LeaderXinjianSun/AutoSteelpasted/PLC/自动贴钢片机（珠海藤仓）资料.xlsx

Sheet: IO表
台达PLC
序号 | 输入端子 | 线标 |  | 工位 | 输出端子 | 线标 | 输出信号 | 工位
1 | X0.O | X0.O | 无杆气缸SET | PCB上料 | Y0.0 | Y0.0 |  | *预留 | AS332T
2 | X0.1 | X0.1 | 无杆气缸RST |  | Y0.1 | Y0.1
3 | X0.2 | X0.2 | 前推气缸SET |  | Y0.2 | Y0.2
4 | X0.3 | X0.3 | 前推气缸RST |  | Y0.3 | Y0.3
5 | X0.4 | X0.4 | 光纤 |  | Y0.4 | Y0.4
6 | X0.5 | X0.5 | 漫反射传感器 |  | Y0.5 | Y0.5
7 | X0.6 | X0.6 | 笼子接近开关1 |  | Y0.6 | Y0.6
8 | X0.7 | X0.7 | 笼子接近开关2 |  | Y0.7 | Y0.7
9 | X0.8 | X0.8 | 下压气缸1SET | 滚压工位 | Y0.8 | Y0.8
10 | X0.9 | X0.9 | 下压气缸2SET |  | Y0.9 | Y0.9
11 | X0.10 | X0.10 | 下压气缸1RST |  | Y0.10 | Y0.10
12 | X0.11 | X0.11 | 下压气缸2RST |  | Y0.11 | Y0.11
13 | X0.12 | X0.12 | 漫反射传感器 | 检测正反 | Y0.12 | Y0.12 | 无杆气缸 | PCB上料
14 | X0.13 | X0.13 | 上顶气缸RST |  | Y0.13 | Y0.13 | 前推气缸
15 | X0.14 | X0.14 | 负压表 |  | Y0.14 | Y0.14 | 下压气缸 | 滚压工位
16 | X0.15 | X0.15 | 漫反射传感器 | 贴膜 | Y0.15 | Y0.15 | 安全门信号输出
17 | X1.0 | X1.0 | 上顶气缸RST |  |  |  |  |  | AS16AM10N-A
18 | X1.1 | X1.1 | 负压表
19 | X1.2 | X1.2 | 漫反射传感器 | 压合
20 | X1.3 | X1.3 | 上顶气缸RST
21 | X1.4 | X1.4 | 负压表
22 | X1.5 | X1.5 | 漫反射传感器 | 撕膜
23 | X1.6 | X1.6 | 上顶气缸RST
24 | X1.7 | X1.7 | 负压表
25 | X1.8 | X1.8 | 漫反射传感器 | 贴钢片
26 | X1.9 | X1.9 | 上顶气缸RST
27 | X1.10 | X1.10 | 负压表
28 | X1.11 | X1.11 | 漫反射传感器 | 再压合
29 | X1.12 | X1.12 | 上顶气缸RST
30 | X1.13 | X1.13 | 负压表
31 | X1.14 | X1.14 | 漫反射传感器 | 检测钢片
32 | X1.15 | X1.15 | 上顶气缸RST
33 | X2.0 | X2.0 | 负压表 |  |  |  |  |  | AS16AM10N-A
34 | X2.1 | X2.1 | 漫反射传感器 | 打记号模组
35 | X2.2 | X2.2 | 上顶气缸RST
36 | X2.3 | X2.3 | 负压表
37 | X2.4 | X2.4 | 下压气缸SET
38 | X2.5 | X2.5 | 下压气缸RST
39 | X2.6 | X2.6 | 无杆气缸SET | 推出气缸
40 | X2.7 | X2.7 | 无杆气缸RST
41 | X2.8 | X2.8 | 无杆气缸SET | PCB下料
42 | X2.9 | X2.9 | 无杆气缸RST
43 | X2.10 | X2.10 | 光纤
44 | X2.11 | X2.11 | 漫反射传感器
45 | X2.12 | X2.12 | 笼子接近开关1
46 | X2.13 | X2.13 | 笼子接近开关2
47 | X2.14 | X2.14 | 无杆气缸SET | 膜上料
48 | X2.15 | X2.15 | 无杆气缸RST
49 | X3.0 | X3.0 | 推入到位接近开关1 |  |  |  |  |  | AS16AM10N-A
50 | X3.1 | X3.1 | 推入到位接近开关2
51 | X3.2 | X3.2 | 光纤1
52 | X3.3 | X3.3 | 光纤2
53 | X3.4 | X3.4 | 漫反射传感器1
54 | X3.5 | X3.5
55 | X3.6 | X3.6 | 无杆气缸SET | 钢片上料
56 | X3.7 | X3.7 | 无杆气缸RST
57 | X3.8 | X3.8 | 气缸RST
58 | X3.9 | X3.9 | 光纤1
59 | X3.10 | X3.10 | 光纤2
60 | X3.11 | X3.11 | 漫反射传感器1
61 | X3.12 | X3.12 | 漫反射传感器2
62 | X3.13 | X3.13 | 负压表
63 | X3.14 | X3.14 | 前门1 | 机壳
64 | X3.15 | X3.15 | 前门2
65 | X4.0 | X4.0 | 左门1 |  |  |  |  |  | AS16AM10N-A
66 | X4.1 | X4.1 | 左门2
67 | X4.2 | X4.2 | 后门1
68 | X4.3 | X4.3 | 后门2
69 | X4.4 | X4.4 | 右门1
70 | X4.5 | X4.5 | 右门2
71 | X4.6 | X4.6 | 急停按钮
72 | X4.7 | X4.7 | 启动按钮
73 | X4.8 | X4.8 | 停止按钮
74 | X4.9 | X4.9 | 复位按钮
75 | X4.10 | X4.10 | 正压表
76 | X4.11 | X4.11 | 到位传感器1 | 钢片上料
77 | X4.12 | X4.12 | 到位传感器2
78 | X4.13 | X4.13
79 | X4.14 | X4.14
80 | X4.15 | X4.15
81 |  |  |  |  | Y1.0 | Y1.0 | 挡块气缸 | 检测正反 | AS16AN01T-A
82 |  |  |  |  | Y1.1 | Y1.1 | 上顶气缸
83 |  |  |  |  | Y1.2 | Y1.2 | 真空吸
84 |  |  |  |  | Y1.3 | Y1.3 | 挡块气缸 | 贴膜
85 |  |  |  |  | Y1.4 | Y1.4 | 上顶气缸
86 |  |  |  |  | Y1.5 | Y1.5 | 真空吸
87 |  |  |  |  | Y1.6 | Y1.6 | 挡块气缸 | 压合
88 |  |  |  |  | Y1.7 | Y1.7 | 上顶气缸
89 |  |  |  |  | Y1.8 | Y1.8 | 真空吸
90 |  |  |  |  | Y1.9 | Y1.9 | 挡块气缸 | 撕膜
91 |  |  |  |  | Y1.10 | Y1.10 | 上顶气缸
92 |  |  |  |  | Y1.11 | Y1.11 | 真空吸
93 |  |  |  |  | Y1.12 | Y1.12 | 挡块气缸 | 再压合
94 |  |  |  |  | Y1.13 | Y1.13 | 上顶气缸
95 |  |  |  |  | Y1.14 | Y1.14 | 真空吸
96 |  |  |  |  | Y1.15 | Y1.15 | 挡块气缸 | 检测钢片
97 |  |  |  |  | Y2.0 | Y2.0 | 上顶气缸 |  | AS16AN01T-A
98 |  |  |  |  | Y2.1 | Y2.1 | 真空吸
99 |  |  |  |  | Y2.2 | Y2.2 | 挡块气缸 | 打记号模组
100 |  |  |  |  | Y2.3 | Y2.3 | 上顶气缸
101 |  |  |  |  | Y2.4 | Y2.4 | 真空吸
102 |  |  |  |  | Y2.5 | Y2.5 | 下压气缸
103 |  |  |  |  | Y2.6 | Y2.6 | 无杆气缸 | 推出气缸
104 |  |  |  |  | Y2.7 | Y2.7 | 上顶气缸
105 |  |  |  |  | Y2.8 | Y2.8 | 无杆气缸 | PCB下料
106 |  |  |  |  | Y2.9 | Y2.9 | 废膜气缸 | 废膜
107 |  |  |  |  | Y2.10 | Y2.10 | 无杆气缸 | 膜上料
108 |  |  |  |  | Y2.11 | Y2.11 | 无杆气缸 | 钢片上料
109 |  |  |  |  | Y2.12 | Y2.12 | 上下气缸
110 |  |  |  |  | Y2.13 | Y2.13 | 真空吸
111 |  |  |  |  | Y2.14 | Y2.14 | 控制灯继电器 | 机壳
112 |  |  |  |  | Y2.15 | Y2.15 | 三色灯-红
97 |  |  |  |  | Y3.0 | Y3.0 | 三色灯-黄 |  | AS16AN01T-A
98 |  |  |  |  | Y3.1 | Y3.1 | 三色灯-绿
99 |  |  |  |  | Y3.2 | Y3.2 | 三色灯-蜂鸣
100 |  |  |  |  | Y3.3 | Y3.3 | 传送带1驱动
101 |  |  |  |  | Y3.4 | Y3.4 | 传送带2驱动
102 |  |  |  |  | Y3.5 | Y3.5 | 滚轮驱动
103 |  |  |  |  | Y3.6 | Y3.6 | 夹爪气缸左 | 钢片上料
104 |  |  |  |  | Y3.7 | Y3.7 | 夹爪气缸右
105 |  |  |  |  | Y3.8 | Y3.8 | 挡块气缸
106 |  |  |  |  | Y3.9 | Y3.9 | 挡块气缸 | 贴钢片
107 |  |  |  |  | Y3.10 | Y3.10 | 上顶气缸
108 |  |  |  |  | Y3.11 | Y3.11 | 真空吸
109 |  |  |  |  | Y3.12 | Y3.12 | 上顶辅助气缸 | 撕膜
110 |  |  |  |  | Y3.13 | Y3.13
111 |  |  |  |  | Y3.14 | Y3.14
112 |  |  |  |  | Y3.15 | Y3.15
机械手1-RC90
序号 | 输入端子 | 线标 |  |  | 输出端子 | 线标 | 输出信号
1 | Input No.0 | IN0 | 负压表 |  | Output No.0 | OUT0 | 真空吸 |  | RC90
2 | Input No.1 | IN1 |  |  | Output No.1 | OUT1 | 吹气
3 | Input No.2 | IN2 |  |  | Output No.2 | OUT2 | 夹爪气缸
4 | Input No.3 | IN3 |  |  | Output No.3 | OUT3 | 下膜夹爪
5 | Input No.4 | IN4 |  |  | Output No.4 | OUT4 | 顶针气缸
6 | Input No.5 | IN5 |  |  | Output No.5 | OUT5
7 | Input No.6 | IN6 |  |  | Output No.6 | OUT6
8 | Input No.7 | IN7 |  |  | Output No.7 | OUT7
9 | Input No.8 | IN8 |  |  | Output No.8 | OUT8
10 | Input No.9 | IN9 |  |  | Output No.9 | OUT9
11 | Input No.10 | IN10 |  |  | Output No.10 | OUT10
12 | Input No.11 | IN11 |  |  | Output No.11 | OUT11
13 | Input No.12 | IN12 |  |  | Output No.12 | OUT12
14 | Input No.13 | IN13 |  |  | Output No.13 | OUT13
15 | Input No.14 | IN14 |  |  | Output No.14 | OUT14
16 | Input No.15 | IN15 |  |  | Output No.15 | OUT15 | 光源控制
17 | Input No.16 | IN16
18 | Input No.17 | IN17
19 | Input No.18 | IN18
20 | Input No.19 | IN19
21 | Input No.20 | IN20
22 | Input No.21 | IN21
23 | Input No.22 | IN22
24 | Input No.23 | IN23
机械手1-RC90
序号 | 输入端子 | 线标 |  |  | 输出端子 | 线标 | 输出信号
1 | Input No.0 | IN0 | 爪手1负压表 |  | Output No.0 | OUT0 | 爪手1真空吸 |  | RC90
2 | Input No.1 | IN1 | 爪手2负压表 |  | Output No.1 | OUT1 | 爪手1吹气
3 | Input No.2 | IN2 | 爪手3负压表 |  | Output No.2 | OUT2 | 爪手1上下气缸
4 | Input No.3 | IN3 | 爪手4负压表 |  | Output No.3 | OUT3 | 爪手2真空吸
5 | Input No.4 | IN4 | 爪手5负压表 |  | Output No.4 | OUT4 | 爪手2吹气
6 | Input No.5 | IN5 |  |  | Output No.5 | OUT5 | 爪手2上下气缸
7 | Input No.6 | IN6 |  |  | Output No.6 | OUT6 | 爪手3真空吸
8 | Input No.7 | IN7 |  |  | Output No.7 | OUT7 | 爪手3吹气
9 | Input No.8 | IN8 |  |  | Output No.8 | OUT8 | 爪手3上下气缸
10 | Input No.9 | IN9 |  |  | Output No.9 | OUT9 | 爪手4真空吸
11 | Input No.10 | IN10 |  |  | Output No.10 | OUT10 | 爪手4吹气
12 | Input No.11 | IN11 |  |  | Output No.11 | OUT11 | 爪手4上下气缸
13 | Input No.12 | IN12 |  |  | Output No.12 | OUT12 | 爪手5真空吸
14 | Input No.13 | IN13 |  |  | Output No.13 | OUT13 | 爪手5吹气
15 | Input No.14 | IN14 |  |  | Output No.14 | OUT14 | 爪手5上下气缸
16 | Input No.15 | IN15 |  |  | Output No.15 | OUT15 | 光源控制
17 | Input No.16 | IN16
18 | Input No.17 | IN17
19 | Input No.18 | IN18
20 | Input No.19 | IN19
21 | Input No.20 | IN20
22 | Input No.21 | IN21
23 | Input No.22 | IN22
24 | Input No.23 | IN23

Sheet: 物料清单 采购格式
 |  |  |  |  |  |  |  |  |  | 文件编号： | LDR-SJ-0220
物料清单（电气）: |  |  |  |  |  |  |  |  |  | 编号：
项目名称： |  | 自动贴钢片机 |  |  | 设计工程师： | 孙鑫建 |  |  | 制 单 时 间： |  | 20170818
客 户： |  | 珠海藤仓 |  |  | 领 料 人： |  |  |  | 装 配 时 间：
数 量： |  |  |  |  | 主 管 签 字： |  |  |  | 经 理 签 字：
序号 | 物料编号 | 物料名称 |  | 型号 |  | 品牌 | 数量 | 单位 | 单价 | 采购件 | 链接
1 |  | 控制 | 电脑主机 |  |  | 研华 | 1 | 台
2 |  |  | PLC 主机 | AS332T |  | 台达 | 1 | 个
3 |  |  | PLC 功能卡（CANopen通讯模块） | AS-FCOPM |  | 台达 | 1 | 个
4 |  |  | PLC IO扩展 | AS16AM10N-A |  | 台达 | 4 | 个
5 |  |  | PLC IO扩展 | AS16AN01T-A |  | 台达 | 3 | 个
6 |  |  | 端子台（AS300端子台，1M牛角插头延长线） | 端子台D024-K 延长线C4002- 1000 |  | 台达 | 1 | 套
7 |  |  | 交换机 | SF90D-16 |  | 思科 | 2 | 个
8 |  |  | 触摸屏 | DOP07SS411 |  | 台达 | 1 | 个
9 |  |  | 网线 | 2m |  |  | 6 | 根
10 |  |  | 网线 | 0.5m |  |  | 6 | 根
11 |  |  | 鼠标 | OP-520 |  | 双飞燕 | 1 | 个
12 |  |  | 键盘 | KL-5 |  | 双飞燕 | 1 | 个
13 |  |  | 笔形相机 | B005+ |  | 超眼 | 1 | 个 |  |  | https://detail.tmall.com/item.htm?id=21048944022&rn=f208cd8221aefa8242105d03a00c6e37&abbucket=3
14 |  |  | 显示器 | E1715S |  | 戴尔 | 1 | 个
15 |  | 视觉 | 工业相机 | MER-1070-10GM-P |  | 大恒 | 3 | 个
16 |  |  | 镜头 | OPT-C0825-5M |  |  | 3 | 个
17 |  |  | 条形光源 | LTS-2BR17530-W |  |  | 2 | 个
18 |  |  | 条形光源 | LTS-2BR7530-W |  |  | 2 | 个
19 |  |  | 背光源 | LTS-2FTR141141-W |  |  | 2 | 个
20 |  |  | 光源控制器 | LTS-DPC2475-4 |  |  | 1 | 个
21 |  |  | 光源控制器 | LTS-DPC2424-2 |  |  | 1 | 个
22 |  | 电机 | 伺服电机（100W，不带刹车） | ECMA-C20401ES |  | 台达 | 2 | 个
23 |  |  | 伺服驱动器（100W，CANopen通讯） | ASD-A2-0121-M |  | 台达 | 3 | 个
24 |  |  | 伺服电机（100W，带刹车） | ECMA-C20401FS |  | 台达 | 1 | 个
25 |  |  | 伺服驱动器(400W，CANopen通讯) | ASD-A2-0421-M |  | 台达 | 4 | 个
26 |  |  | 伺服电机(400W，带刹车) | ECMA-C20604SS |  | 台达 | 4 | 个
27 |  |  | 伺服线 |  |  | 台达 | 7 | 套
28 |  |  | 伺服CN1 |  |  | 台达 | 6 | 个
29 |  |  | 机械手 | LS3-401S |  | EPSON | 2 | 台
30 |  |  | 机器人控制器 | RC90 |  | EPSON | 2 | 台
31 |  |  | 脉冲发生器 | DKC-1A |  |  | 3 | 个
32 |  |  | 步进电机 | 57CM26 |  | 雷赛 | 1 | 个
33 |  |  | 步进电机 | 57HS13B-M |  | 雷赛 | 4 | 个
34 |  |  | 步进电机驱动器 | DM542 |  | 雷赛 | 5 | 个
35 |  | 电源 | 空气开关 | DZ47s-2P D10 |  | 德力西 | 5 | 个
36 |  |  | 漏电保护开关 | DZ47sLE C32 |  | 德力西 | 1 | 个
37 |  |  | 手柄+负荷开关 | VCF1C+V1C（32A） |  | 施耐德 | 1 | 个
38 |  |  | 单相滤波器 | SJD430D-30A |  | 上海赛纪 | 1 | 个
39 |  | 机柜 | 三色灯 | XVG-B3SM |  | 施耐德 | 1 | 个
40 |  |  | 风扇 | DLF1224LB |  |  | 6 | 个
41 |  |  | 按钮 | XB5AA31C NO |  | 施耐德 | 3 | 个
42 |  |  | 急停按钮 | XB5AS542C 1NC |  | 施耐德 | 4 | 个
43 |  |  | 急停按钮黄色标牌 |  |  |  | 4 | 个
44 |  |  | 急停按钮保护罩 |  |  |  | 4 | 个
45 |  |  | 电源指示灯 | XB7EVM3LC |  | 施耐德 | 1 | 个
46 |  |  | 防暴LED灯 |  |  |  | 1 | 个
47 |  |  | 门开关 | FM18-08N |  |  | 8 | 个
48 |  |  | 继电器 | MY2N-GS |  |  | 10 | 个
49 |  |  | 开关电源 | NDR-120-24 120W |  | 铭纬 | 1 | 个
50 |  |  | 开关电源 | NDR-480-24 480W |  | 铭纬 | 1 | 个
51 |  |  | 传感器(方缸) | DS1-J |  | SMC | 4 | 个
52 |  |  | 传感器（无杆气缸） | GL-8H |  | SMC | 16 | 个
53 |  |  | 传感器（下料上下） | DMSH-020 |  | SMC | 3 | 个
54 |  |  | 光纤传感器 | FU-35 |  | 基恩士 | 4 | 个
55 |  |  | 光纤放大器 | FS-V21R |  | 基恩士 | 4 | 个
56 |  |  | 光纤传感器 | PT3Y20 |  | BOJKE | 2 | 个
57 |  |  | 光纤放大器 | ER2-22 |  | BOJKE | 2 | 个
58 |  |  | 激光光电传感器 | BG-40N |  | BOJKE | 2 | 个
59 |  |  | 光电传感器 | E3ZG-D61 |  | 欧姆龙 | 13 | 个
60 |  |  | 光电开关 | LU672-5NA |  | HUAYIFENG | 16 | 个 |  |  | http://www.hyfcn.com/caoxingguangdianchuanganqi/40-30.html
61 |  |  | 转接板 | ST081N |  |  | 18 | 个
62 |  |  | 开关面板 | 118型十孔 |  | 公牛 | 1 | 个
63 |  |  | 开关面板暗盒 | 118型十孔暗盒 |  | 公牛 | 1 | 个
64 |  |  | DB50端子台 | 孔座 |  |  | 2 | 个
65 |  |  | DB25端子台 | 孔座 |  |  | 2 | 个
66 |  |  | DB50连接线 | 公对母3米 |  |  | 2 | 个
67 |  |  | DB25连接线 | 公对母3米 |  |  | 2 | 个
68 |  | 气动 | 电磁阀 | SY3120-12连 |  | SMC | 2 | 个
69 |  |  | 电磁阀 | SY3120-7连 |  | SMC | 1 | 个
70 |  |  | 电磁阀 | SY3120单体 |  | SMC | 7 | 个
71 |  |  | 电磁阀 | 3V21008NCBI |  | 亚德客 | 10 | 个
72 |  |  | 多功能真空发生器 | ZK2A07K5KW-06 |  | SMC | 6 | 个
73 |  |  | 负压表 | DP-101 |  | 松下 | 9 | 个
74 |  |  | 电源线 | 2m |  |  | 2 | 根
75 |  |  | VGA线 | 3m |  |  | 1 | 根
76 |  |  | 接地柱 |  |  |  | 1 | 个
77 |  |  | 接地排 |  |  |  | 1 | 个
78 |  |  | 2.5mm 导线（黑色） |  |  |  |  | 米
79 |  |  | 2.5mm 导线 （蓝色） |  |  |  |  | 米
80 |  |  | 2.5mm 导线 （黄绿） |  |  |  |  | 米
81 |  |  | 1 mm 导线 （红色） |  |  |  |  | 米
82 |  |  | 1 mm 导线 （白色） |  |  |  |  | 米
83 |  |  | 0.5mm 导线 （黑色） |  |  |  |  | 米
84 |  |  | 多芯线 10芯 |  |  |  |  | 米
85 |  |  | 捷固端子 |  |  |  |  | 个
86 |  |  | 接地端子 |  |  |  |  | 个
87 |  |  | U型线鼻子 |  |  |  |  | 个
88 |  |  | 空中接头 |  |  |  |  | 个
89 |  |  | O型线鼻子 |  |  |  |  | 个
90 |  |  | 马鞍型固定座 |  |  |  |  | 个
91 |  |  | 导轨 |  |  |  |  | 米
92 |  |  | 线槽 |  |  |  |  | 米
93 |  |  | 插头 |  |  |  | 1 | 个

Sheet: 装配规划
工位 | PCB上料 |  |  | 工位 | 滚压 |  |  | 工位 | 检测正反 |  |  | 工位 | 贴膜 |  |  | 工位 | 压合 |  |  | 工位 | 撕膜
输入 | 数量 | 输出 | 数量 | 输入 | 数量 | 输出 | 数量 | 输入 | 数量 | 输出 | 数量 | 输入 | 数量 | 输出 | 数量 | 输入 | 数量 | 输出 | 数量 | 输入 | 数量 | 输出 | 数量
无杆气缸接近开关 | 2 | 无杆气缸 | 1 | 下压气缸传感器 | 4 | 下压气缸 | 1 | 漫反射传感器 | 1 | 挡块气缸 | 1 | 漫反射传感器 | 1 | 挡块气缸 | 1 | 漫反射传感器 | 1 | 挡块气缸 | 1 | 漫反射传感器 | 1 | 挡块气缸 | 1
前推气缸传感器 | 2 | 前推气缸 | 1 |  |  |  |  | 上顶气缸传感器 | 1 | 上顶气缸 | 1 | 上顶气缸传感器 | 1 | 上顶气缸 | 1 | 上顶气缸传感器 | 1 | 上顶气缸 | 1 | 上顶气缸传感器 | 1 | 上顶气缸 | 1
电机极限 | 2 |  |  |  |  |  |  | 负压表 | 1 | 真空吸 | 1 | 负压表 | 1 | 真空吸 | 1 | 负压表 | 1 | 真空吸 | 1 | 负压表 | 1 | 真空吸 | 1
光纤 | 1 |  |  |  |  |  |  |  |  |  |  |  |  |  |  |  |  | 单作用气缸 | 1
漫反射传感器 | 1
笼子接近开关 | 2
 |  |  |  | 工位 | 贴钢片 |  |  | 工位 | 压合 |  |  | 工位 | 检测钢片 |  |  | 工位 | 打记号模组 |  |  | 工位 | 推出气缸 |  |  | 工位 | PCB下料
 |  |  |  | 输入 | 数量 | 输出 | 数量 | 输入 | 数量 | 输出 | 数量 | 输入 | 数量 | 输出 | 数量 | 输入 | 数量 | 输出 | 数量 | 输入 | 数量 | 输出 | 数量 | 输入 | 数量 | 输出 | 数量
 |  |  |  | 漫反射传感器 | 1 | 挡块气缸 | 1 | 漫反射传感器 | 1 | 挡块气缸 | 1 | 漫反射传感器 | 1 | 挡块气缸 | 1 | 漫反射传感器 | 1 | 挡块气缸 | 1 | 无感气缸传感器 | 2 | 无杆气缸 | 1 | 无杆气缸接近开关 | 2 | 无杆气缸 | 1
 |  |  |  | 上顶气缸传感器 | 1 | 上顶气缸 | 1 | 上顶气缸传感器 | 1 | 上顶气缸 | 1 | 上顶气缸传感器 | 1 | 上顶气缸 | 1 | 上顶气缸传感器 | 1 | 上顶气缸 | 1 |  |  | 上顶气缸 | 1 | 电机极限 | 2
 |  |  |  | 负压表 | 1 | 真空吸 | 1 | 负压表 | 1 | 真空吸 | 1 | 负压表 | 1 | 真空吸 | 1 | 负压表 | 1 | 真空吸 | 1 |  |  |  |  | 光纤 | 1
 |  |  |  |  |  |  |  |  |  | 单作用气缸 | 1 |  |  |  |  | 电机极限 | 4 | 下压气缸 | 1 |  |  |  |  | 漫反射传感器 | 1
 |  |  |  |  |  |  |  |  |  |  |  |  |  |  |  | 气缸传感器 | 2 |  |  |  |  |  |  | 笼子接近开关 | 2
 |  |  |  | 工位 | 机械手1 |  |  | 工位 | 废膜 |  |  | 工位 | 机械手2
 |  |  |  | 输入 | 数量 | 输出 | 数量 | 输入 | 数量 | 输出 | 数量 | 输入 | 数量 | 输出 | 数量
 |  |  |  | 负压表 | 1 | 气缸 | 1 |  |  | 气缸 | 1 | 负压表 | 5 | 气缸 | 5
 |  |  |  |  |  | 真空吸 | 1 |  |  |  |  |  |  | 真空吸 | 5
 |  |  |  |  |  | 吹气 | 1 |  |  |  |  |  |  | 吹气 | 5
工位 | 机壳 |  |  | 工位 | 膜上料 |  |  | 工位 | 钢片上料
输入 | 数量 | 输出 | 数量 | 输入 | 数量 | 输出 | 数量 | 输入 | 数量 | 输出 | 数量
门感应 | 8 | 三色灯 | 1 | 电机极限 | 2 | 无杆气缸 | 1 | 电机极限 | 4 | 无杆气缸 | 1
急停 | 1 |  |  | 无杆气缸传感器 | 2 |  |  | 无杆气缸传感器 | 2 | 上下气缸 | 1
按钮 | 3 |  |  | 推入到位传感器 | 2 |  |  | 气缸传感器 | 1 | 真空吸 | 1
 |  |  |  | 膜到位光纤 | 2 |  |  | 膜到位光纤 | 2
 |  |  |  | 漫反射传感器 | 1 |  |  | 漫反射传感器 | 2
 |  |  |  |  |  |  |  | 负压表 | 1

Sheet: 多芯线
多芯线编号 | 序号 | 颜色 | 线标 |  | 区域
1 | 1 | 红 |  | 24V | PCB上料
 | 2 | 黑 | X0.O | 无杆气缸SET
 | 3 | 棕 | X0.1 | 无杆气缸RST
 | 4 | 橙 | X0.2 | 前推气缸SET
 | 5 | 黄 | X0.3 | 前推气缸RST
 | 6 | 绿 | X0.4 | 光纤
 | 7 | 兰 | X0.5 | 漫反射传感器
 | 8 | 紫 | X0.6 | 笼子接近开关1
 | 9 | 灰 | X0.7 | 笼子接近开关2
 | 10 | 白 |  | 0V
多芯线编号 | 序号 | 颜色 |  |  | 区域 | 传送带1
2 | 1 | 红 |  | 24V | PCB上料
 | 2 | 黑 | LIM1+ | 电机1极限+
 | 3 | 棕 | LIM1- | 电机1极限-
 | 4 | 橙
 | 5 | 黄
 | 6 | 绿
 | 7 | 兰
 | 8 | 紫
 | 9 | 灰
 | 10 | 白 |  | 0V
多芯线编号 | 序号 | 颜色 |  |  | 区域
3 | 1 | 红 |  | 24V
 | 2 | 黑 | X0.8 | 下压气缸1SET | 滚压工位
 | 3 | 棕 | X0.9 | 下压气缸2SET
 | 4 | 橙 | X0.10 | 下压气缸1RST
 | 5 | 黄 | X0.11 | 下压气缸2RST
 | 6 | 绿 | X0.12 | 漫反射传感器 | 检测正反
 | 7 | 兰 | X0.13 | 上顶气缸RST
 | 8 | 紫 | X0.14 | 负压表
 | 9 | 灰 | X0.15 | 漫反射传感器 | 贴膜
 | 10 | 白 |  | 0V
多芯线编号 | 序号 | 颜色 |  |  | 区域
4 | 1 | 红 |  | 24V
 | 2 | 黑 | X1.0 | 上顶气缸RST | 贴膜
 | 3 | 棕 | X1.1 | 负压表
 | 4 | 橙 | X1.2 | 漫反射传感器 | 压合
 | 5 | 黄 | X1.3 | 上顶气缸RST
 | 6 | 绿 | X1.4 | 负压表
 | 7 | 兰 | X1.5 | 漫反射传感器 | 撕膜
 | 8 | 紫 | X1.6 | 上顶气缸RST
 | 9 | 灰 | X1.7 | 负压表
 | 10 | 白 |  | 0V
多芯线编号 | 序号 | 颜色 |  |  | 区域 | 传送带2
5 | 1 | 红 |  | 24V
 | 2 | 黑 | X1.8 | 漫反射传感器 | 贴钢片
 | 3 | 棕 | X1.9 | 上顶气缸RST
 | 4 | 橙 | X1.10 | 负压表 | 再压合
 | 5 | 黄 | X1.11 | 漫反射传感器
 | 6 | 绿 | X1.12 | 上顶气缸RST
 | 7 | 兰 | X1.13 | 负压表 | 检测钢片
 | 8 | 紫 | X1.14 | 漫反射传感器
 | 9 | 灰 | X1.15 | 上顶气缸RST
 | 10 | 白 |  | 0V
多芯线编号 | 序号 | 颜色 |  |  | 区域
6 | 1 | 红 |  | 24V
 | 2 | 黑 | X2.0 | 负压表 | 打记号模组
 | 3 | 棕 | X2.1 | 漫反射传感器
 | 4 | 橙 | X2.2 | 上顶气缸RST
 | 5 | 黄 | X2.3 | 负压表
 | 6 | 绿 | LIM7+ | 电机7极限+
 | 7 | 兰 | LIM7- | 电机7极限-
 | 8 | 紫 | X2.6 | 无杆气缸SET | 推出气缸
 | 9 | 灰 | X2.7 | 无杆气缸RST
 | 10 | 白 |  | 0V
多芯线编号 | 序号 | 颜色 |  |  | 区域 | 移动模组
7 | 1 | 红 |  | 24V
 | 2 | 黑 | LIM6+ | 电机6极限+ | 打记号模组
 | 3 | 棕 | LIM6- | 电机6极限-
 | 4 | 橙 | X2.4 | 下压气缸SET
 | 5 | 黄 | X2.5 | 下压气缸RST
 | 6 | 绿
 | 7 | 兰
 | 8 | 紫
 | 9 | 灰
 | 10 | 白 |  | 0V
多芯线编号 | 序号 | 颜色 |  |  | 区域
8 | 1 | 红 |  | 24V
 | 2 | 黑 | X2.8 | 无杆气缸SET | PCB下料
 | 3 | 棕 | X2.9 | 无杆气缸RST
 | 4 | 橙 | X2.10 | 光纤
 | 5 | 黄 | X2.11 | 漫反射传感器
 | 6 | 绿 | X2.12 | 笼子接近开关1
 | 7 | 兰 | X2.13 | 笼子接近开关2
 | 8 | 紫 | LIM5+ | 电机5极限+
 | 9 | 灰 | LIM5- | 电机5极限-
 | 10 | 白 |  | 0V
多芯线编号 | 序号 | 颜色 |  |  | 区域
9 | 1 | 红 |  | 24V
 | 2 | 黑 | X2.14 | 无杆气缸SET | 膜上料
 | 3 | 棕 | X2.15 | 无杆气缸RST
 | 4 | 橙 | X3.0 | 推入到位接近开关1
 | 5 | 黄 | X3.1 | 推入到位接近开关2
 | 6 | 绿 | X3.2 | 光纤1
 | 7 | 兰 | X3.3 | 光纤2
 | 8 | 紫 | X3.4 | 漫反射传感器1
 | 9 | 灰
 | 10 | 白 |  | 0V
多芯线编号 | 序号 | 颜色 |  |  | 区域
10 | 1 | 红 |  | 24V
 | 2 | 黑 | LIM2+ | 电机2极限+ | 膜上料
 | 3 | 棕 | LIM2- | 电机2极限-
 | 4 | 橙
 | 5 | 黄
 | 6 | 绿
 | 7 | 兰
 | 8 | 紫
 | 9 | 灰
 | 10 | 白 |  | 0V
多芯线编号 | 序号 | 颜色 |  |  | 区域
11 | 1 | 红 |  | 24V
 | 2 | 黑 | X3.6 | 无杆气缸SET | 钢片上料
 | 3 | 棕 | X3.7 | 无杆气缸RST
 | 4 | 橙 | X3.8 | 气缸RST
 | 5 | 黄 | X3.9 | 光纤1
 | 6 | 绿 | X3.10 | 光纤2
 | 7 | 兰 | X3.11 | 漫反射传感器1
 | 8 | 紫 | X3.12 | 漫反射传感器2
 | 9 | 灰 | X3.13 | 负压表
 | 10 | 白 |  | 0V
多芯线编号 | 序号 | 颜色 |  |  | 区域
12 | 1 | 红 |  | 24V
 | 2 | 黑 | LIM3+ | 电机3极限+ | 钢片上料
 | 3 | 棕 | LIM3- | 电机3极限-
 | 4 | 橙 | LIM4+ | 电机4极限+
 | 5 | 黄 | LIM4- | 电机4极限-
 | 6 | 绿
 | 7 | 兰
 | 8 | 紫
 | 9 | 灰
 | 10 | 白 |  | 0V
多芯线编号 | 序号 | 颜色 |  |  | 区域 | 机械手1
13 | 1 | 红 |  | 24V
 | 2 | 黑 | IN0 | 负压表 | 机械手1
 | 3 | 棕 | OUT0 | 真空吸
 | 4 | 橙 | OUT1 | 吹气
 | 5 | 黄 | OUT2 | 夹爪气缸
 | 6 | 绿
 | 7 | 兰
 | 8 | 紫
 | 9 | 灰
 | 10 | 白 |  | 0V
多芯线编号 | 序号 | 颜色 |  |  | 区域 | 机械手2
14 | 1 | 红 |  | 24V
 | 2 | 黑 | IN0 | 爪手1负压表 | 机械手2
 | 3 | 棕 | IN1 | 爪手2负压表
 | 4 | 橙 | IN2 | 爪手3负压表
 | 5 | 黄 | IN3 | 爪手4负压表
 | 6 | 绿 | IN4 | 爪手5负压表
 | 7 | 兰 | OUT0 | 爪手1真空吸
 | 8 | 紫 | OUT1 | 爪手1吹气
 | 9 | 灰 | OUT2 | 爪手1上下气缸
 | 10 | 白 |  | 0V
多芯线编号 | 序号 | 颜色 |  |  | 区域
15 | 1 | 红 |  | 24V
 | 2 | 黑 | OUT3 | 爪手2真空吸 | 机械手2
 | 3 | 棕 | OUT4 | 爪手2吹气
 | 4 | 橙 | OUT5 | 爪手2上下气缸
 | 5 | 黄 | OUT6 | 爪手3真空吸
 | 6 | 绿 | OUT7 | 爪手3吹气
 | 7 | 兰 | OUT8 | 爪手3上下气缸
 | 8 | 紫 | OUT9 | 爪手4真空吸
 | 9 | 灰 | OUT10 | 爪手4吹气
 | 10 | 白 |  | 0V
多芯线编号 | 序号 | 颜色 |  |  | 区域
16 | 1 | 红 |  | 24V
 | 2 | 黑 | OUT11 | 爪手4上下气缸 | 机械手2
 | 3 | 棕 | OUT12 | 爪手5真空吸
 | 4 | 橙 | OUT13 | 爪手5吹气
 | 5 | 黄 | OUT14 | 爪手5上下气缸
 | 6 | 绿
 | 7 | 兰
 | 8 | 紫
 | 9 | 灰
 | 10 | 白 |  | 0V
多芯线编号 | 序号 | 颜色 |  |  | 区域 | 机壳
17 | 1 | 红 |  | 24V
 | 2 | 黑 | X3.14 | 前门1 | 机壳
 | 3 | 棕 | X3.15 | 前门2
 | 4 | 橙 | X4.0 | 左门1
 | 5 | 黄 | X4.1 | 左门2
 | 6 | 绿 | X4.2 | 后门1
 | 7 | 兰 | X4.3 | 后门2
 | 8 | 紫 | X4.4 | 右门1
 | 9 | 灰 | X4.5 | 右门2
 | 10 | 白 |  | 0V
多芯线编号 | 序号 | 颜色 |  |  | 区域
18 | 1 | 红 |  | 24V
 | 2 | 黑 | X4.6 | 急停按钮 | 机壳
 | 3 | 棕 | X4.7 | 启动按钮
 | 4 | 橙 | X4.8 | 停止按钮
 | 5 | 黄 | X4.9 | 复位按钮
 | 6 | 绿 | Y2.15 | 三色灯-红
 | 7 | 兰 | Y3.0 | 三色灯-黄
 | 8 | 紫 | Y3.1 | 三色灯-绿
 | 9 | 灰 | Y3.2 | 三色灯-蜂鸣
 | 10 | 白 |  | 0V

Sheet: 伺服端子接线图
线序 | 颜色 | 端子号 | 线标 | 信号
1 | 粉 | 1 | DO4+ | 刹车+
2 | 红 | 11 | COM+ | 公共端+
3 | 褐 | 26 | DO4- | 刹车-
4 | 蓝 | 31 | DI7- | PL正转极限
5 | 绿 | 32 | DI6- | NL反转极限
6 | 黄 | 49 | COM- | 公共端-

Sheet: 编程规划
 |  |  | 导程
 |  |  | 5
 |  |  | 10
 |  | M5000
轴1 | PCB上料
轴2 | 膜上料
轴3 | 钢片上料左
轴4 | 钢片上料右
轴5 | PCB下料
轴6 | 打记号Y轴
轴7 | 打记号X轴
M100 | 与机械手1通信
M200 | 与机械手2通信
M300 | 与上位机通信

Sheet: 通信
 | PLC | PC |  |  |  |  |  | PLC | 机械手1 |  |  |  |  |  | PLC | 机械手2
 | 输入 |  |  | 输出 |  |  |  | 输入 |  |  | 输出 |  |  |  | 输入 |  |  | 输出
1 | M350 | YY0 | 检测正反完成 | M300 | XX0 | 检测正反工位RDY | 1 | M150 | PLCOUT0 | 膜取完成 | M100 | PLCIN0 | 膜左RDY | 1 | M250 | PLCOUT0 | 钢片取完成 | M200 | PLCIN0 | 钢片RDY
2 | M351 | YY1 | 检测钢片完成 | M301 | XX1 | 检测钢片工位RDY | 2 | M151 | PLCOUT1 | 夹爪气缸 | M101 | PLCIN1 | 膜右RDY | 2 | M251 | PLCOUT1 | 贴钢片完成 | M201 | PLCIN1 | 贴钢片工位RDY
3 | M352 | YY2 | 钢片1结果 | M302 | XX2 |  | 3 | M152 | PLCOUT2 | 贴膜完成 | M102 | PLCIN2 | 贴膜工位RDY | 3 | M252 | PLCOUT2 |  | M202 | PLCIN2 | 钢片上料安全
4 | M353 | YY3 | 钢片2结果 | M303 | XX3 |  | 4 | M153 | PLCOUT3 | 撕膜完成 | M103 | PLCIN3 | 撕膜工位RDY | 4 | M253 | PLCOUT3 |  | M203 | PLCIN3
5 | M354 | YY4 | 钢片3结果 | M304 | XX4 |  | 5 | M154 | PLCOUT4 |  | M104 | PLCIN4 |  | 5 | M254 | PLCOUT4 |  | M204 | PLCIN4
6 | M355 | YY5 | 钢片4结果 | M305 | XX5 |  | 6 | M155 | PLCOUT5 |  | M105 | PLCIN5 |  | 6 | M255 | PLCOUT5 |  | M205 | PLCIN5
7 | M356 | YY6 | 钢片5结果 | M306 | XX6 |  | 7 | M156 | PLCOUT6 |  | M106 | PLCIN6 |  | 7 | M256 | PLCOUT6 |  | M206 | PLCIN6
8 | M357 | YY7 | 钢片6结果 | M307 | XX7 |  | 8 | M157 | PLCOUT7 |  | M107 | PLCIN7 |  | 8 | M257 | PLCOUT7 |  | M207 | PLCIN7
9 | M358 | YY8 | 钢片7结果 | M308 | XX8 |  | 9 | M158 | PLCOUT8 |  | M108 | PLCIN8 |  | 9 | M258 | PLCOUT8 |  | M208 | PLCIN8
10 | M359 | YY9 | 钢片8结果 | M309 | XX9
11 | M360 | YY10 | 钢片9结果 | M310 | XX10 | 等待PCB板上料篮
12 | M361 | YY11 | 钢片10结果 | M311 | XX11 | 等待胶上料
13 | M362 | YY12 | 钢片11结果 | M312 | XX12 | 等待钢片上料
14 | M363 | YY13 | 钢片12结果 | M313 | XX13 | 等待钢片空盘取走
15 | M364 | YY14 | 钢片13结果 | M314 | XX14 | 等待PCB板下料篮
16 | M365 | YY15 | 钢片14结果 | M315 | XX15 | 等待钢片上料
17 | M366 | YY16 | 钢片15结果 | M316 | XX16 | 等待钢片空盘取走
18 | M367 | YY17 | 钢片16结果 | M317 | XX17 | 产量到达设定值
19 | M368 | YY18 | 钢片17结果 | M318 | XX18
20 | M369 | YY19 | 钢片18结果 | M319 | XX19
21 | M370 | YY20 | 钢片19结果 | M320 | XX20
22 | M371 | YY21 | 钢片20结果 | M321 | XX21
23 | M372 | YY22 | 钢片21结果 | M322 | XX22
24 | M373 | YY23 | 钢片22结果 | M323 | XX23
25 | M374 | YY24 | 钢片23结果 | M324 | XX24
26 | M375 | YY25 | 钢片24结果 | M325 | XX25
27 | M376 | YY26 | 钢片25结果 | M326 | XX26
28 | M377 | YY27 |  | M327 | XX27
29 | M378 | YY28 |  | M328 | XX28
30 | M379 | YY29 |  | M329 | XX29
31 | M380 | YY30 |  | M330 | XX30
32 | M381 | YY31 |  | M331 | XX31
33 | M382 | YY32 |  | M332 | XX32
34 | M383 | YY33 |  | M333 | XX33
35 | M384 | YY34 |  | M334 | XX34
36 | M385 | YY35 |  | M335 | XX35
37 | M386 | YY36 |  | M336 | XX36
38 | M387 | YY37 |  | M337 | XX37
39 | M388 | YY38 |  | M338 | XX38
40 | M389 | YY39 |  | M339 | XX39
41 | M390 | YY40 | 急停信号 | M340 | XX40
42 | M391 | YY41 | PCB上料确认 | M341 | XX41
43 | M392 | YY42 | 膜上料确认 | M342 | XX42
44 | M393 | YY43 | 钢片上料确认 | M343 | XX43
45 | M394 | YY44 | 钢片空盘取走确认 | M344 | XX44
46 | M395 | YY45 | PCB下料确认 | M345 | XX45
47 | M396 | YY46 | 钢片退料 | M346 | XX46
48 | M397 | YY47 |  | M347 | XX47
49 | M398 | YY48 | 机械手1暂停 | M348 | XX48
50 | M399 | YY49 | 机械手2暂停 | M349 | XX49

Sheet: Sheet2
206.608 | 208.007 | -185.778
117.034 | 118.433 | -289.394
89.574
89.574 | 208.007 | -25.904 | -25.904
 |  | 103.616 | 103.616
211.115 | 210.995
0.12 | 0.03
 |  |  | 271.543
 |  |  | 245.543 | 245.543
 |  |  | 219.543 | 219.543
 |  |  | 193.543 | 193.543
 |  |  | 167.543 | 167.543
 |  |  | 141.543
 |  |  | 115.543
 |  |  | 89.543
 |  |  | 63.543
 |  |  | 37.543

Sheet: 报警
M4000 | 钢片空盘吸取失败
M4001 | 暂停
M4002 | 急停
M4003 | 运行
M4004 | 前门1
M4005 | 前门2
M4006 | 左门1
M4007 | 左门2
M4008 | 后门1
M4009 | 后门2
M4010 | 右门1
M4011 | 右门2
M4012 | PCB上料轴伺服报警
M4013 | 膜上料轴伺服报警
M4014 | 钢片左轴伺服报警
M4015 | 钢片右轴伺服报警
M4016 | PCB下料轴伺服报警
M4017 | AOIX轴伺服报警
M4018 | AOIY轴伺服报警
M4019
M4020 | 机械手1暂停
M4021 | 机械手2暂停
M4022 | 等待PCB板上料篮
M4023 | 等待胶上料
M4024 | 等待钢片上料
M4025 | 等待钢片空盘取走
M4026 | 等待PCB板下料篮
M4027 | 等待钢片上料
M4028 | 等待钢片空盘取走
M4029 | 产量到达设定值
M4030
M4031 | 检测正反工位真空吸未达到
M4032 | 贴胶工位真空吸未达到
M4033 | 压合工位真空吸未达到
M4034 | 撕上膜工位真空吸未达到
M4035 | 贴钢片工位真空吸未达到
M4036 | 再压合工位真空吸未达到
M4037 | AOI工位真空吸未达到
M4038 | 做记号工位无杆气缸未到位
M4039
M4040
