LeaderXinjianSun/AutoSteelpasted/(list of files, cad)

Other CAD files:
GangpianRobot1/Main.obj
PLC/自动贴钢片机/01.dwg
GangpianRobot1/GangpianRobot1.obj
PLC/自动贴钢片机/06.dwg
PLC/自动贴钢片机/19.dwg
PLC/自动贴钢片机/05.dwg
PLC/自动贴钢片机/08.dwg
PLC/自动贴钢片机/11.dwg
PLC/自动贴钢片机/21.dwg
PLC/自动贴钢片机/16.dwg
PLC/自动贴钢片机/24.dwg
PLC/自动贴钢片机/22.dwg
PLC/自动贴钢片机/04.dwg
PLC/自动贴钢片机/10.dwg
PLC/自动贴钢片机/14.dwg
PLC/自动贴钢片机/07.dwg
PLC/自动贴钢片机/17.dwg
PLC/自动贴钢片机/12.dwg
PLC/自动贴钢片机/13.dwg
PLC/自动贴钢片机/26.dwg
PLC/自动贴钢片机/09.dwg
PLC/自动贴钢片机/23.dwg
PLC/自动贴钢片机/02.dwg
PLC/自动贴钢片机/25.dwg
PLC/自动贴钢片机/20.dwg
PLC/自动贴钢片机/15.dwg
PLC/自动贴钢片机/18.dwg
PLC/自动贴钢片机/03.dwg
