LeaderXinjianSun/AutoSteelpasted/PLC/珠海藤仓自动贴钢片机电路图.pdf

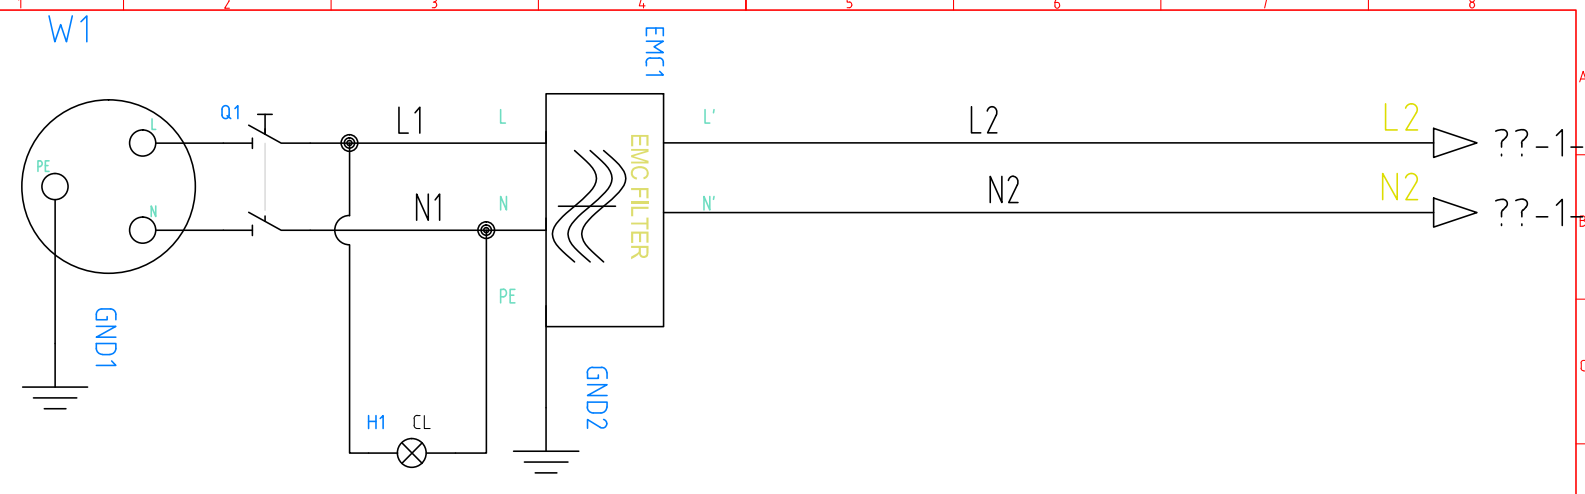
[picture p1: page 1]

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

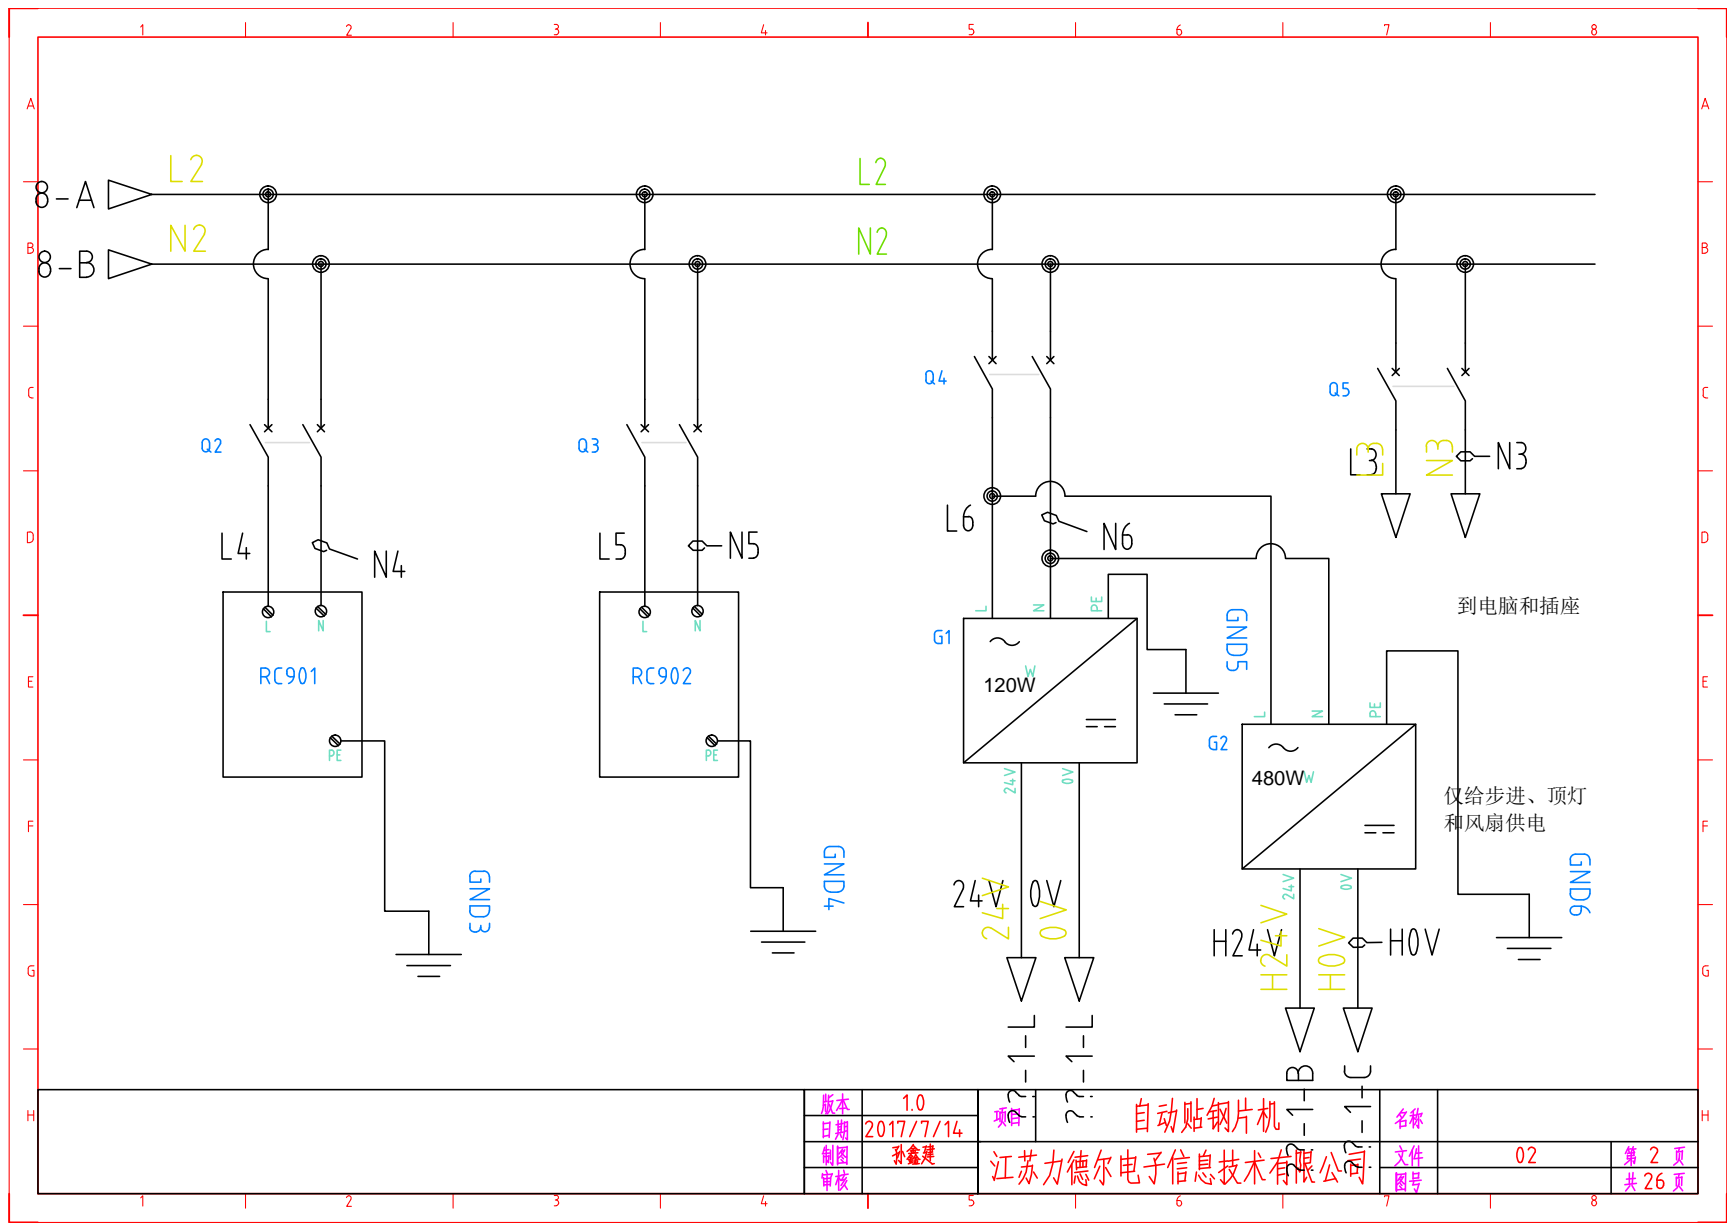
[picture p2: page 2]

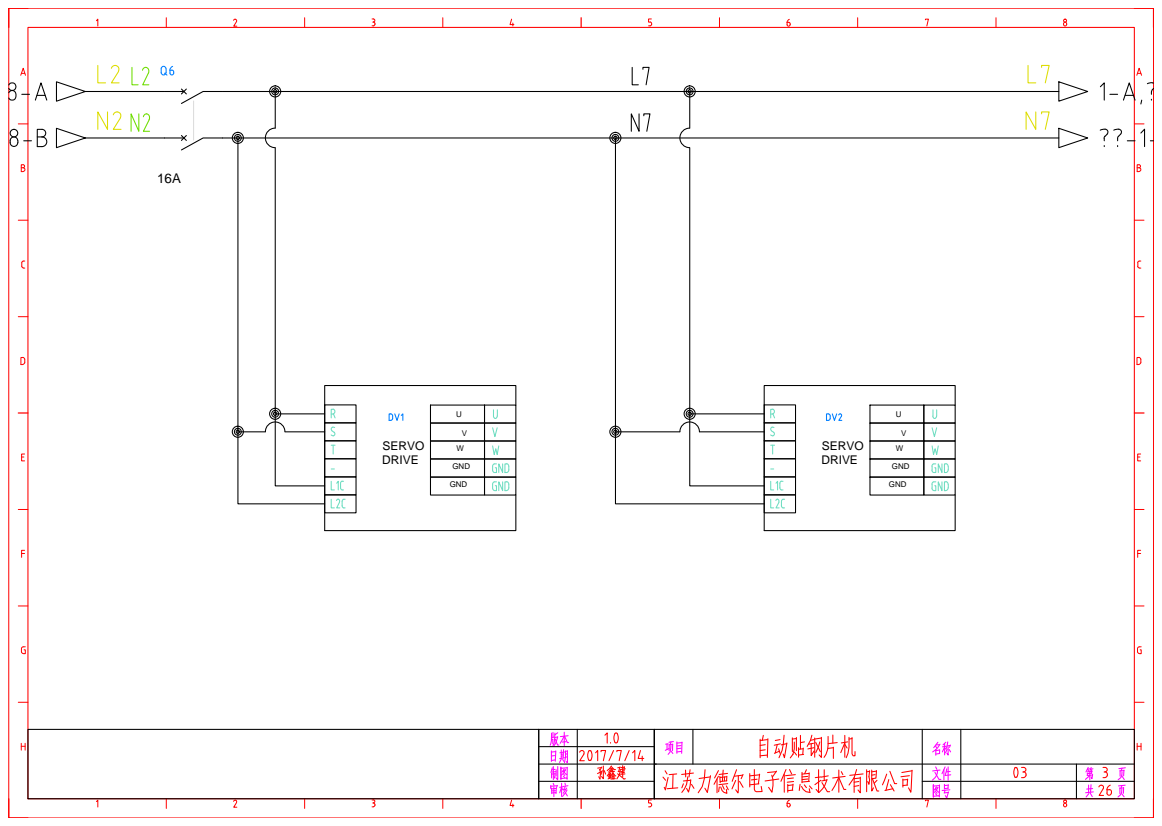
[picture p3: page 3]
GND W; VUGND SERVO DRIVE

VUGND SERVO DRIVE 16A

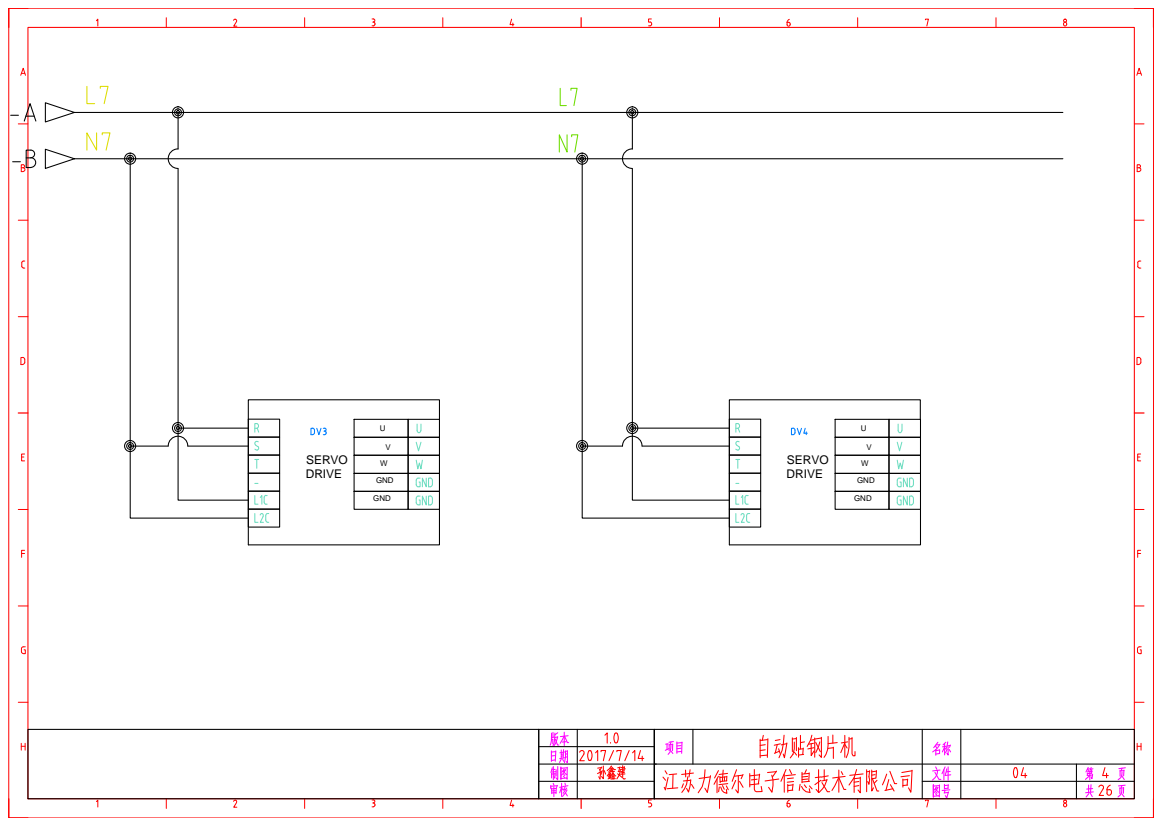
[picture p4: page 4]
GND W; VUGND SERVO DRIVE

VUGND SERVO DRIVE

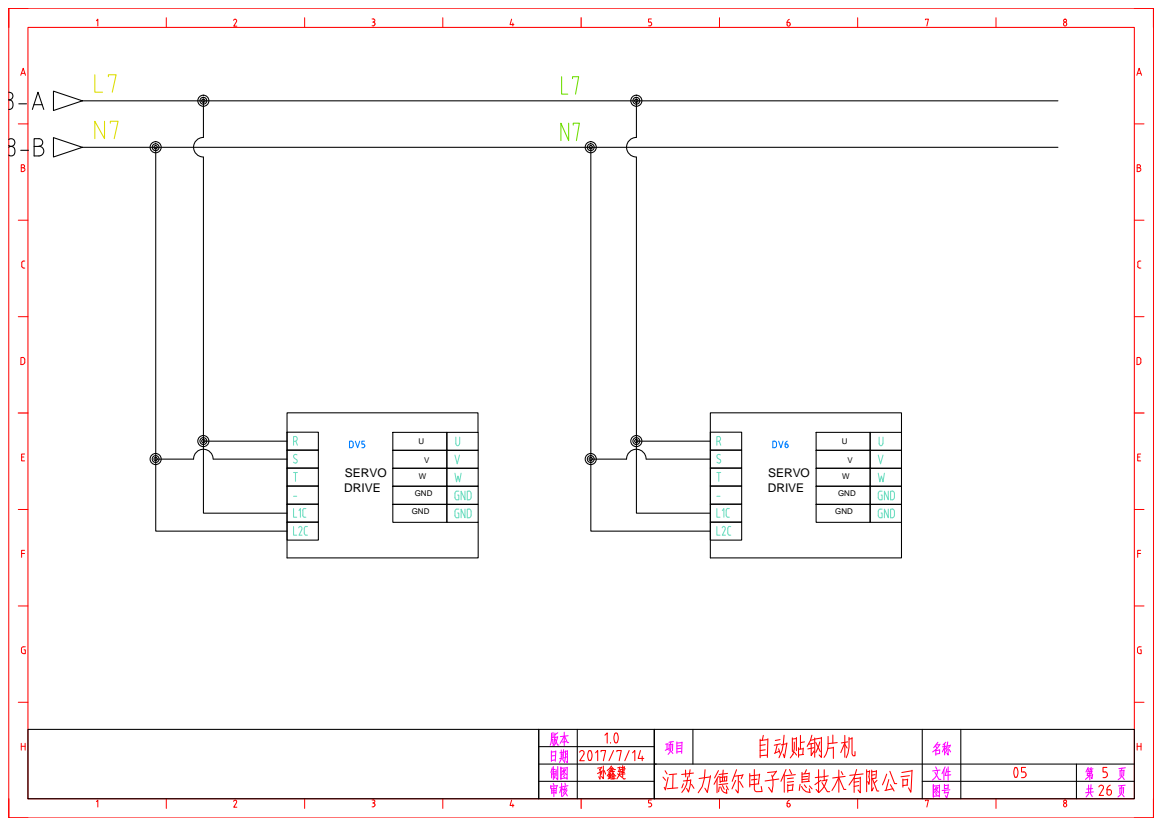
[picture p5: page 5]
GND W; VUGND SERVO DRIVE

VUGND SERVO DRIVE

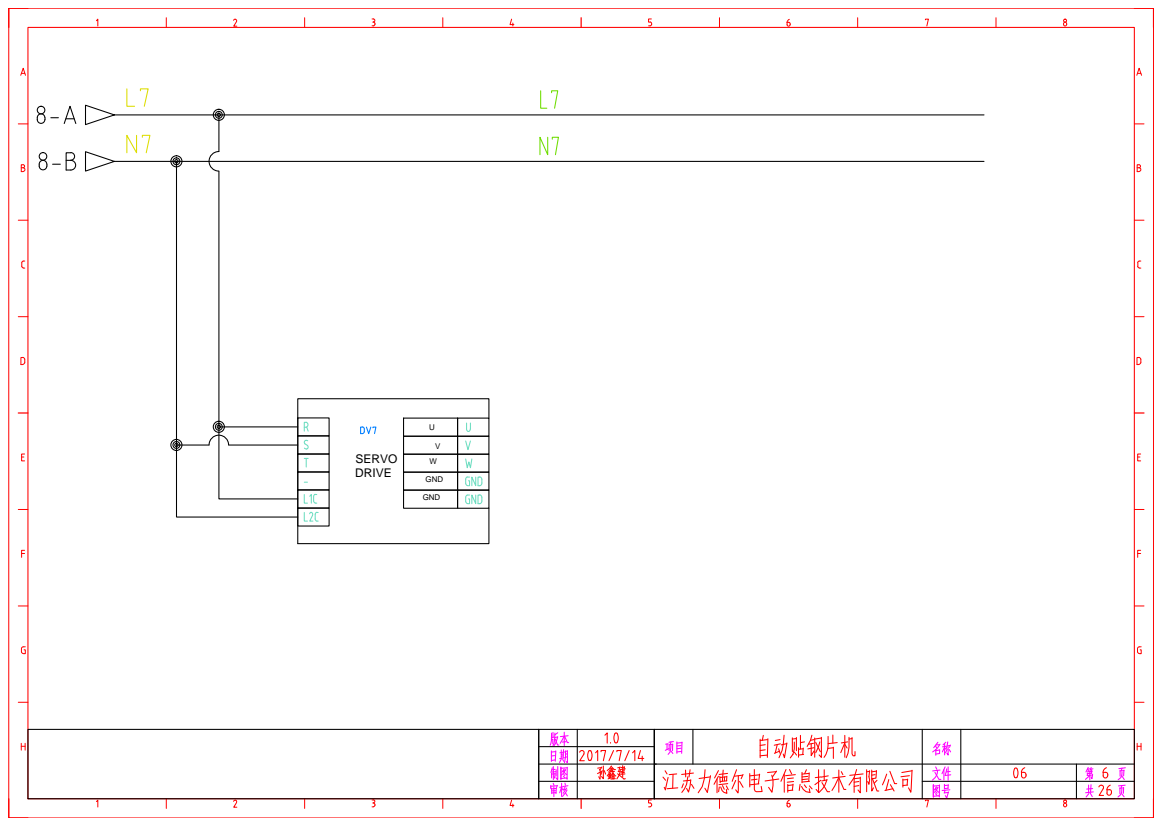
[picture p6: page 6]

GND WVUGND SERVO DRIVE

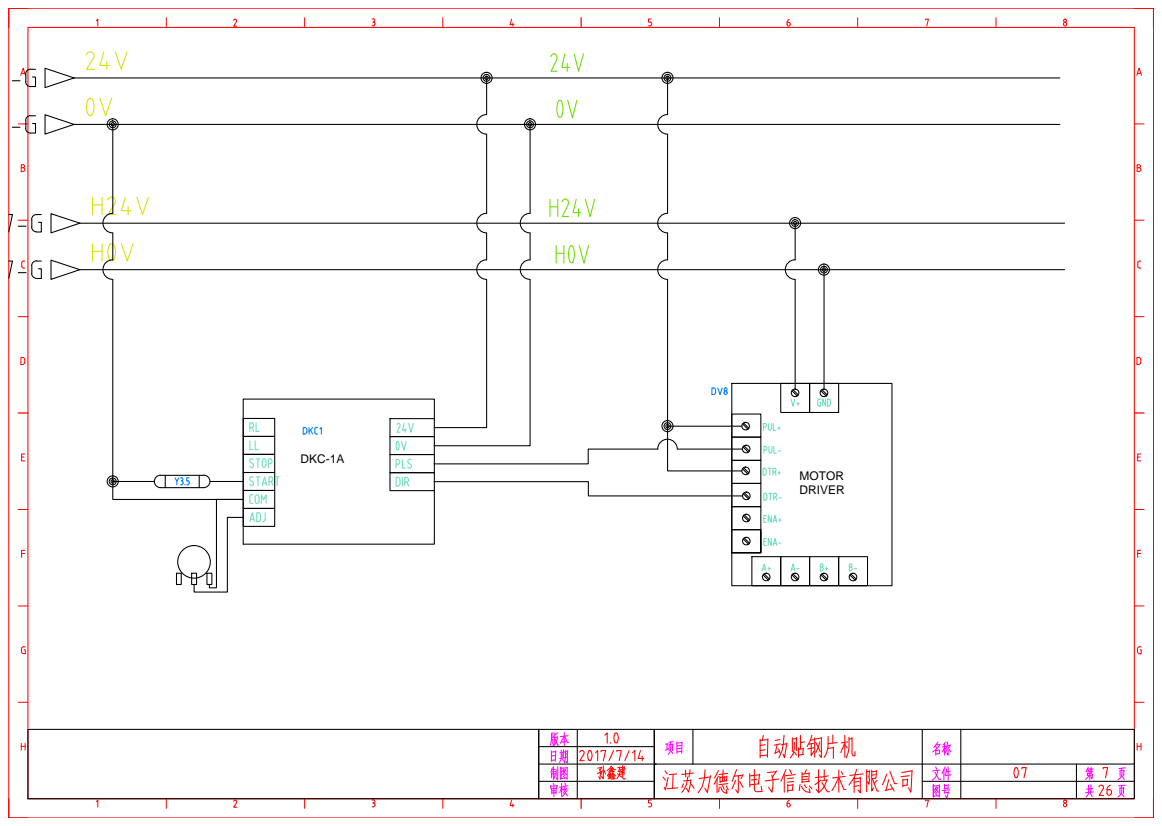
[picture p7: page 7]

MOTOR DRIVER DKC-1A

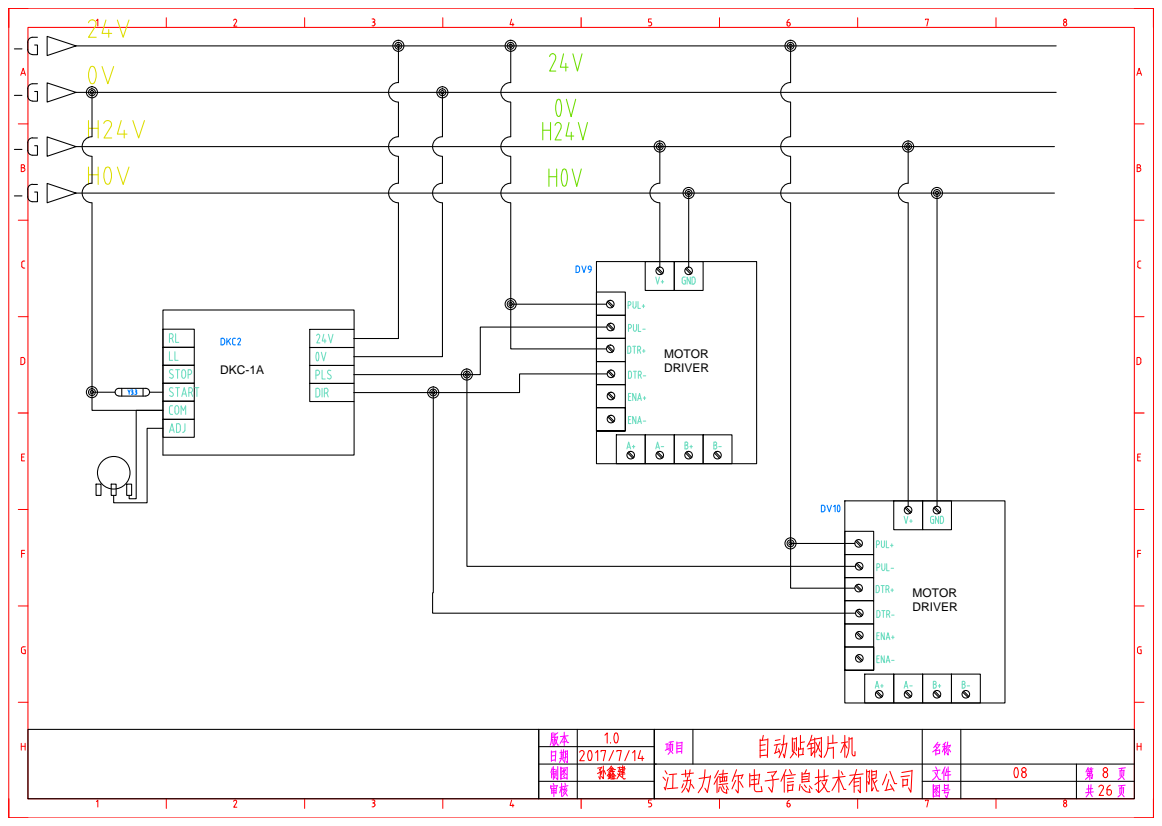
[picture p8: page 8]
DKC-1A; MOTOR DRIVER

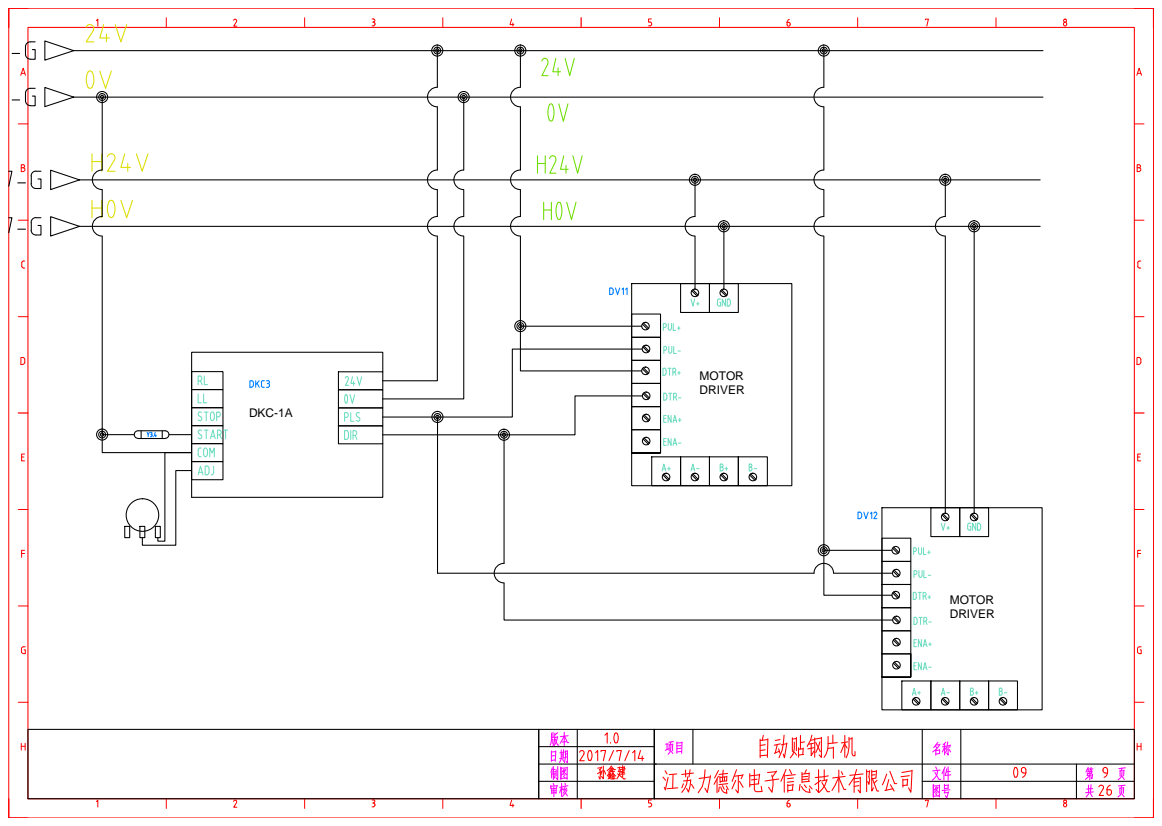
[picture p9: page 9]
MOTOR DRIVER; MOTOR DRIVER DKC-1A

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

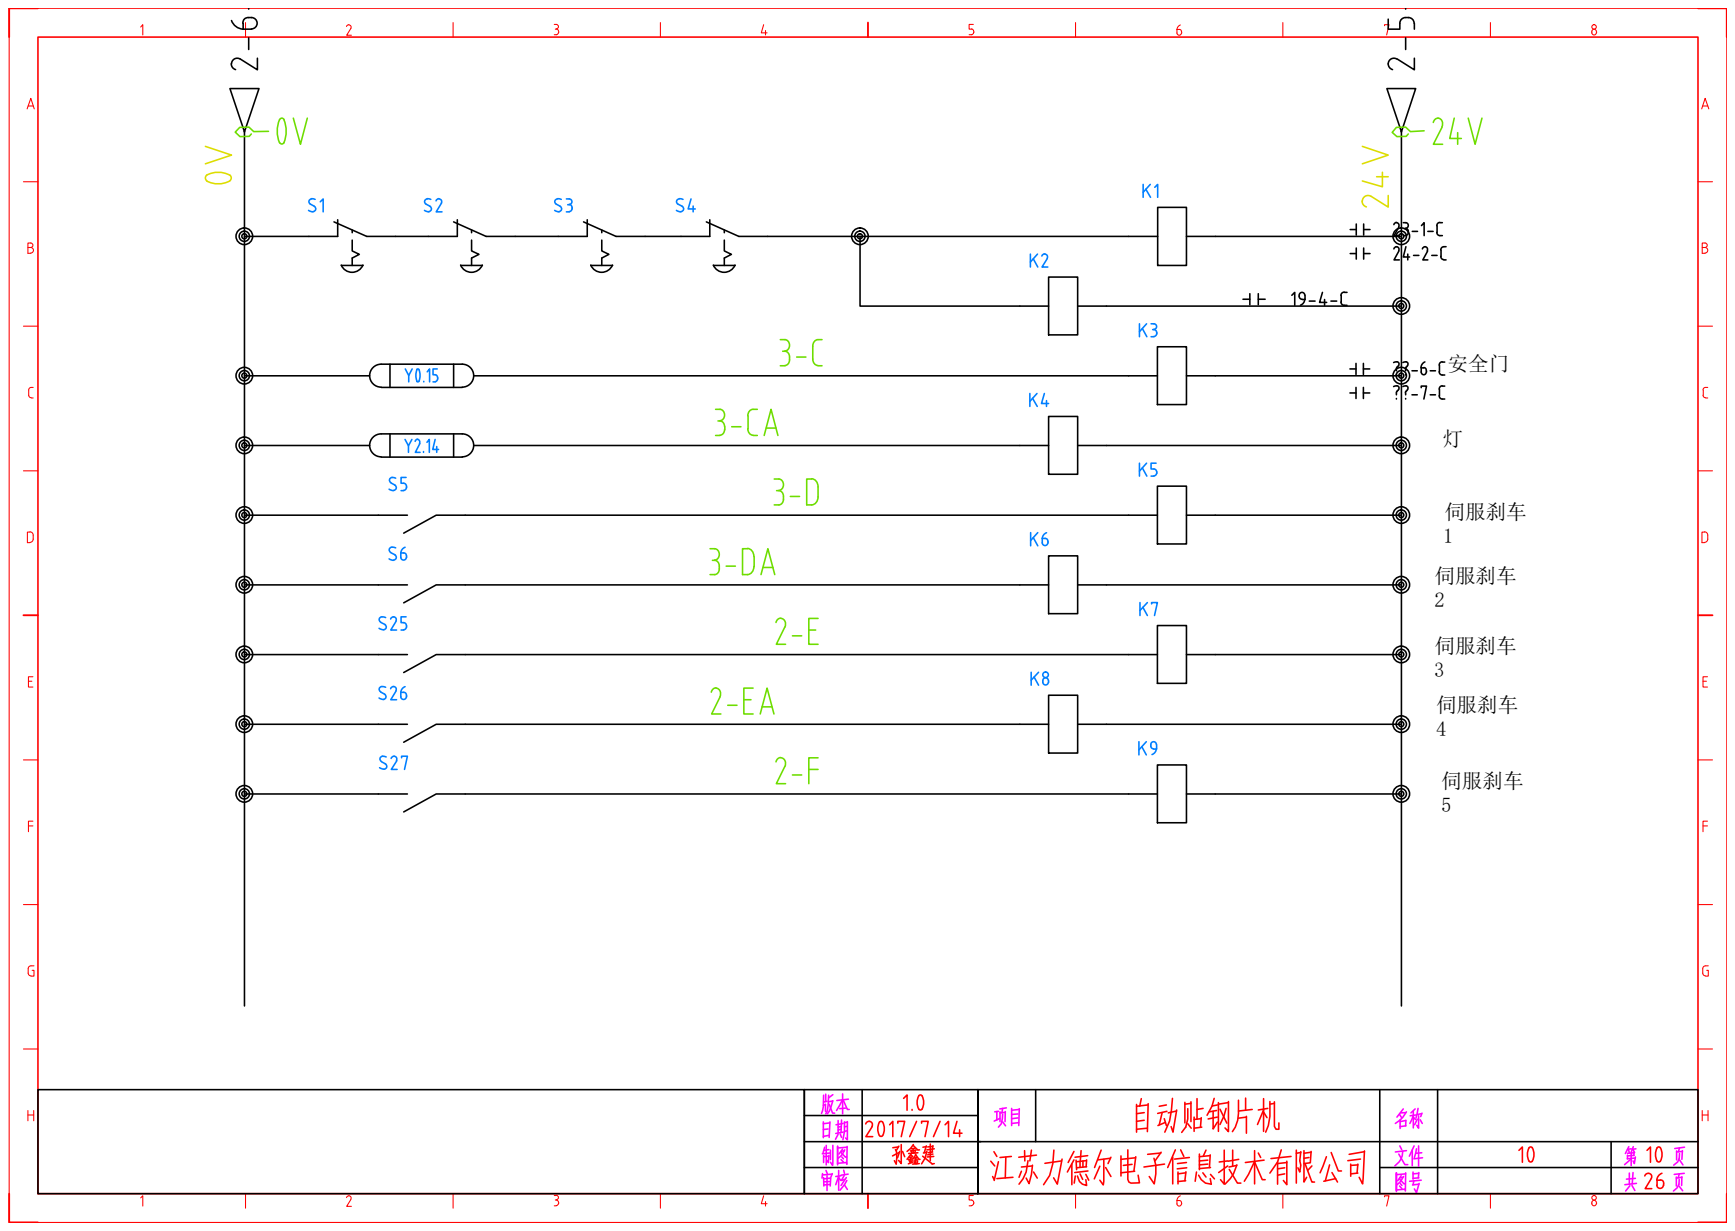
[picture p10: page 10]

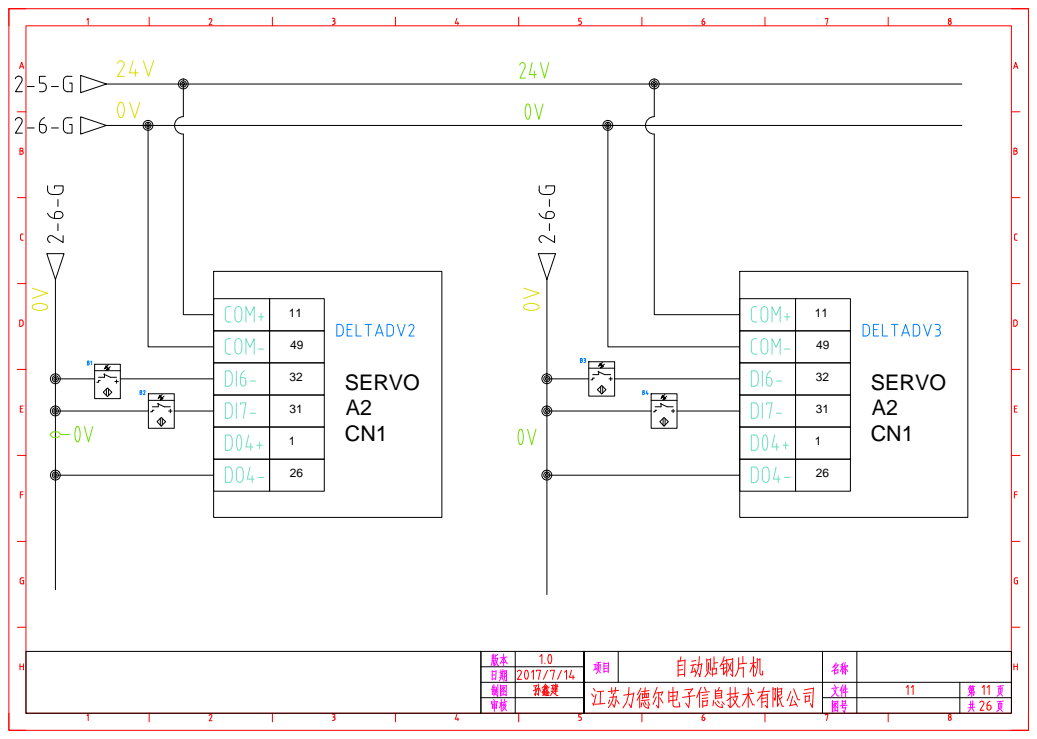
[picture p11: page 11]
SERVO A2 CN1 11493231

SERVO A2 CN1 11493231

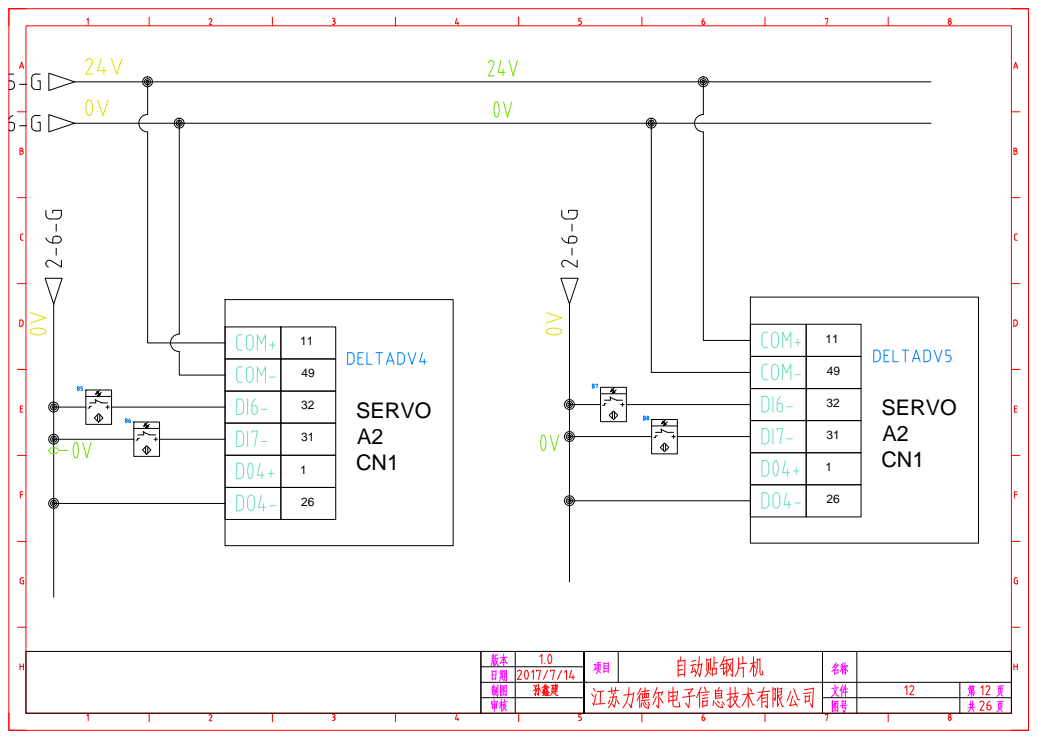
[picture p12: page 12]
SERVO A2 CN1 11493231

SERVO A2 CN1 11493231

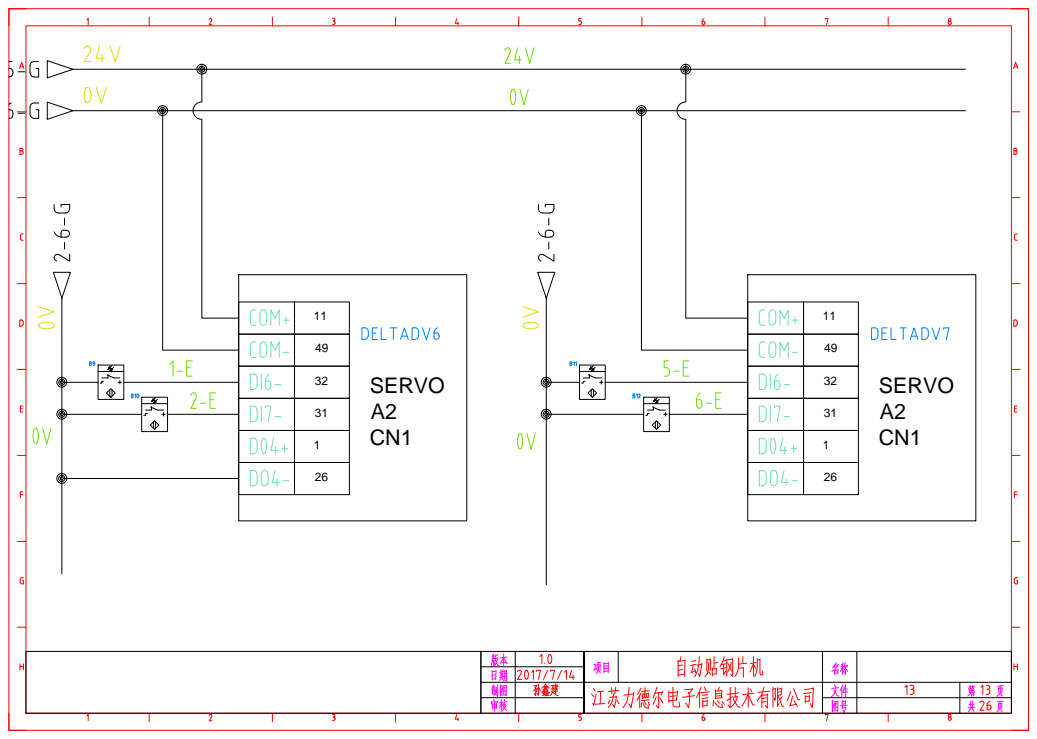
[picture p13: page 13]
SERVO A2 CN1 11493231

SERVO A2 CN1 11493231

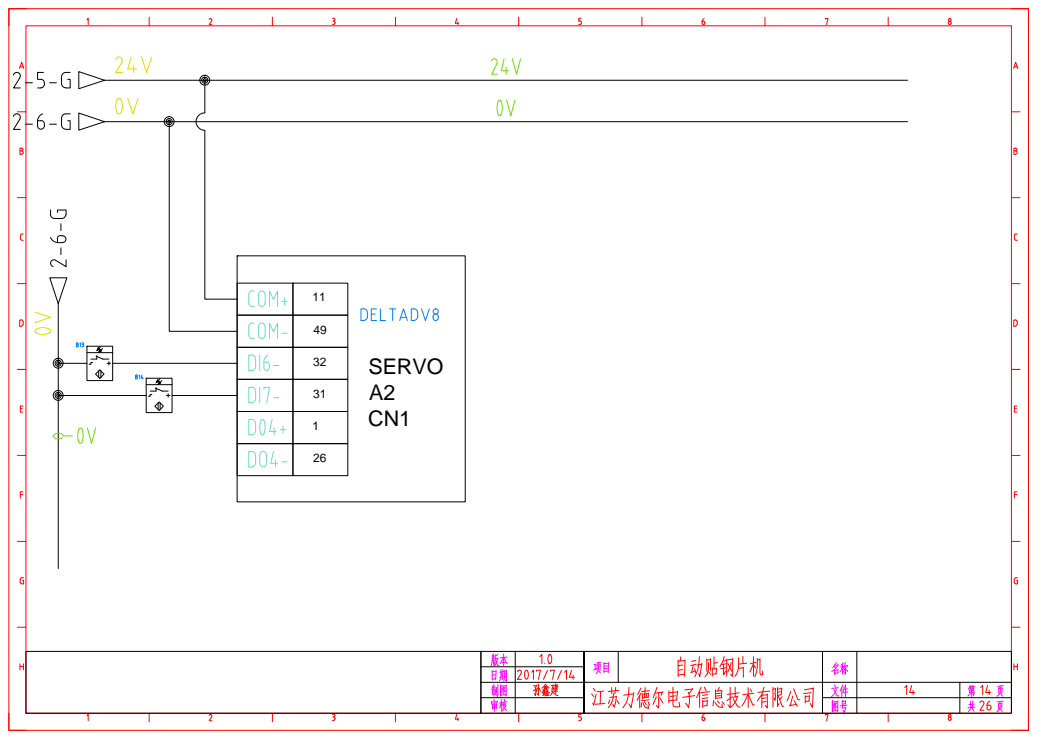
[picture p14: page 14]

SERVO A2 CN1 11493231

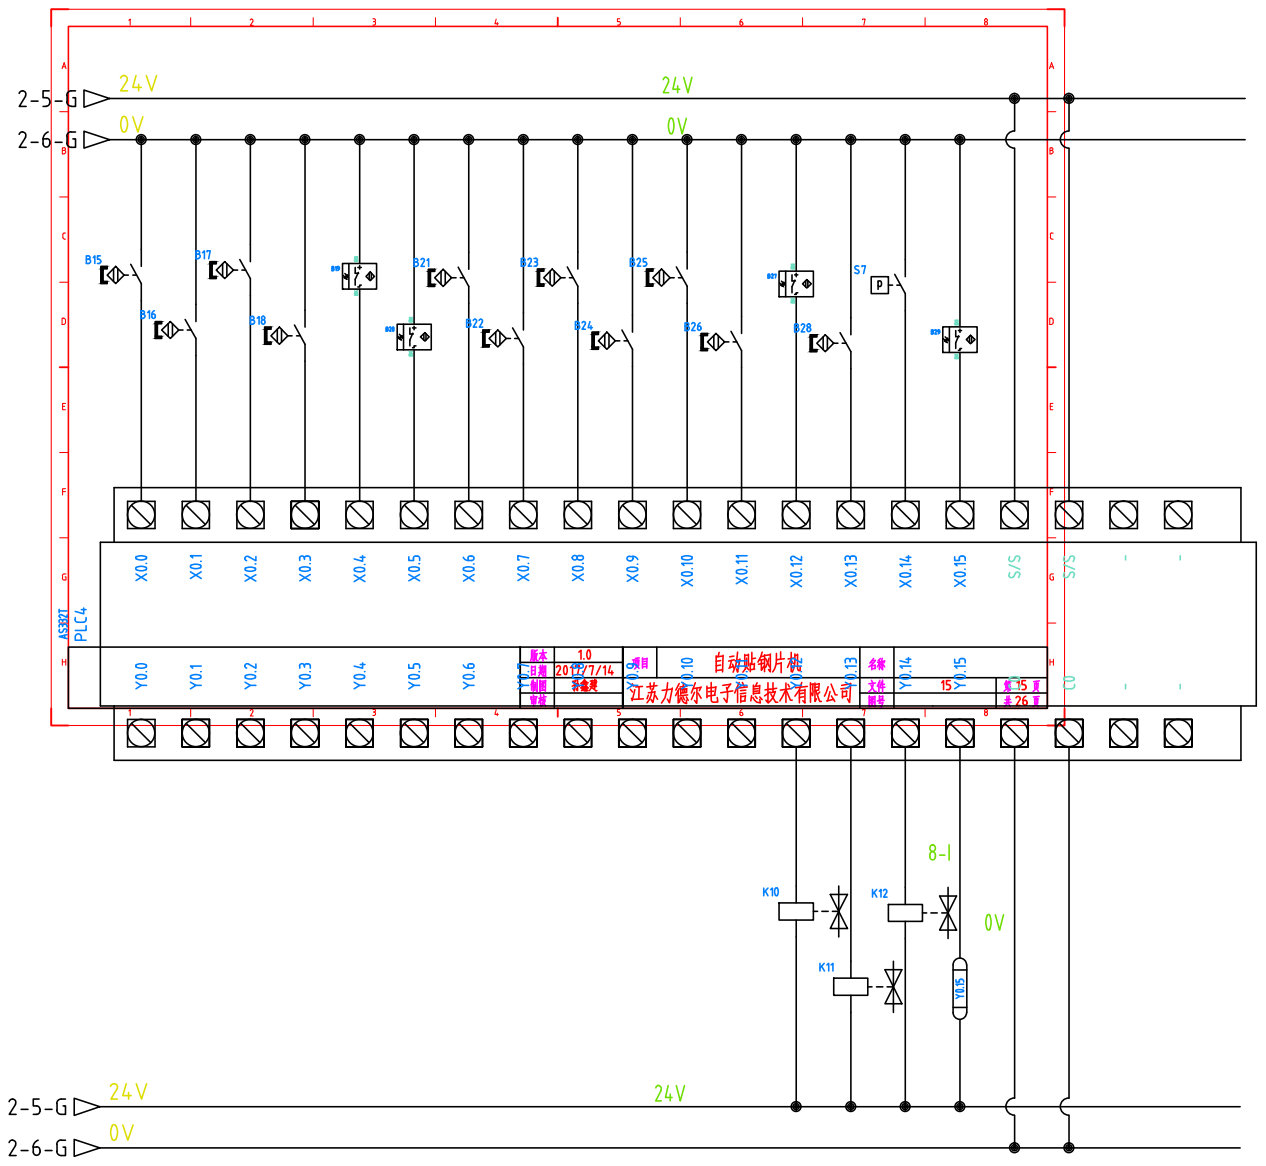
[picture p15: page 15]

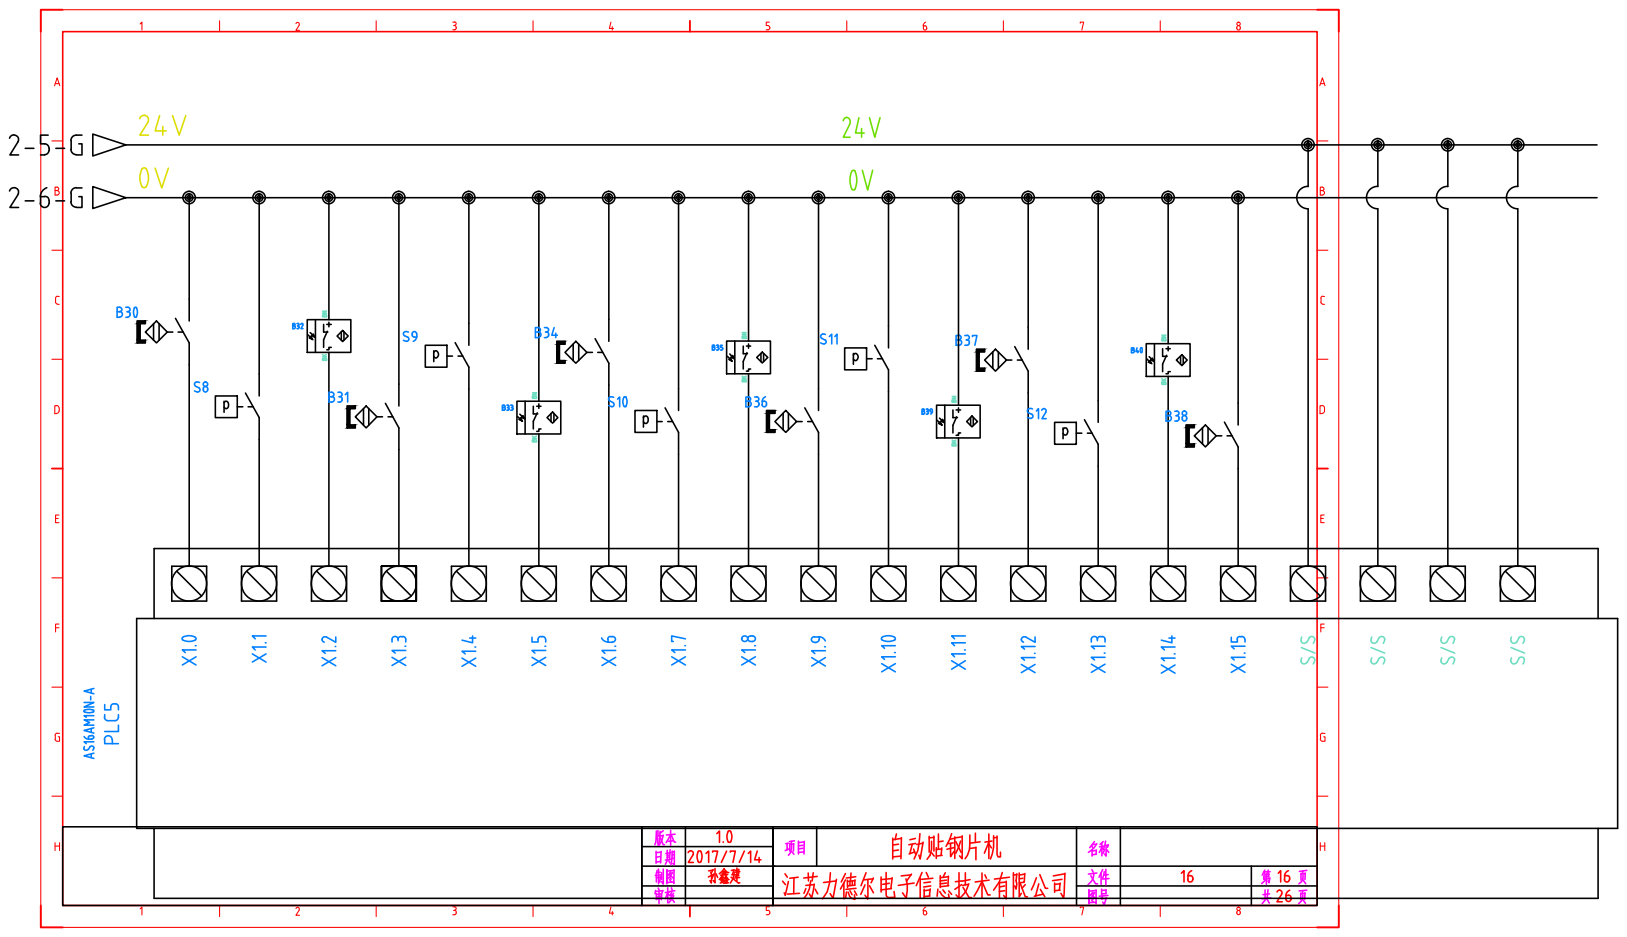
[picture p16: page 16]

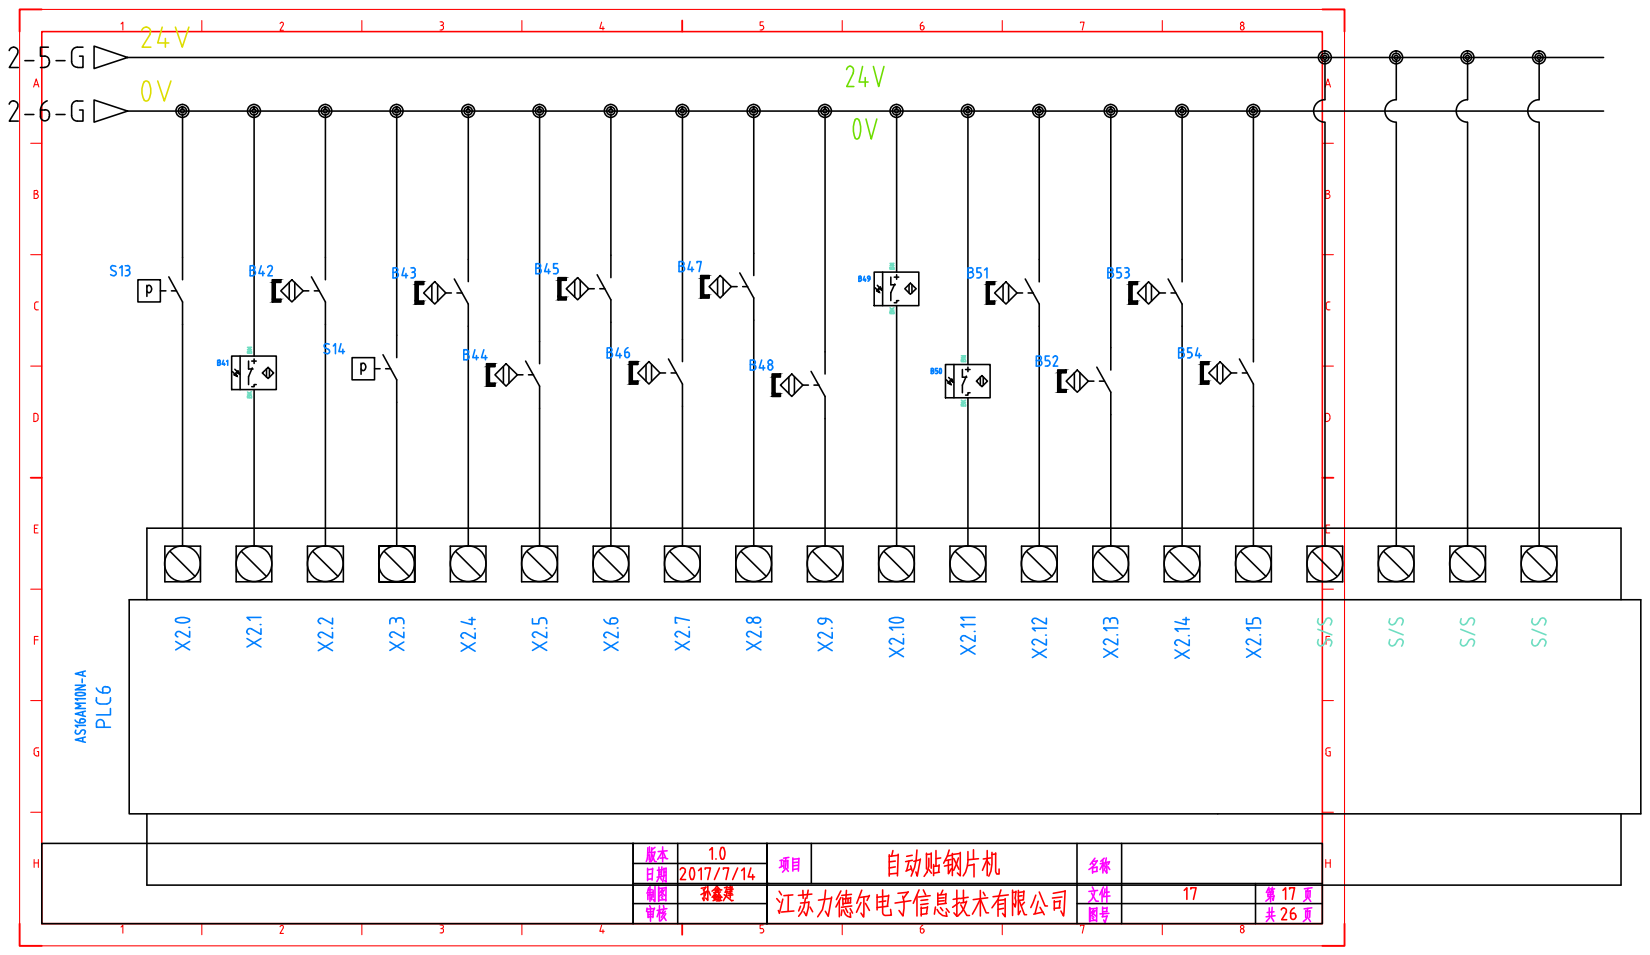
[picture p17: page 17]

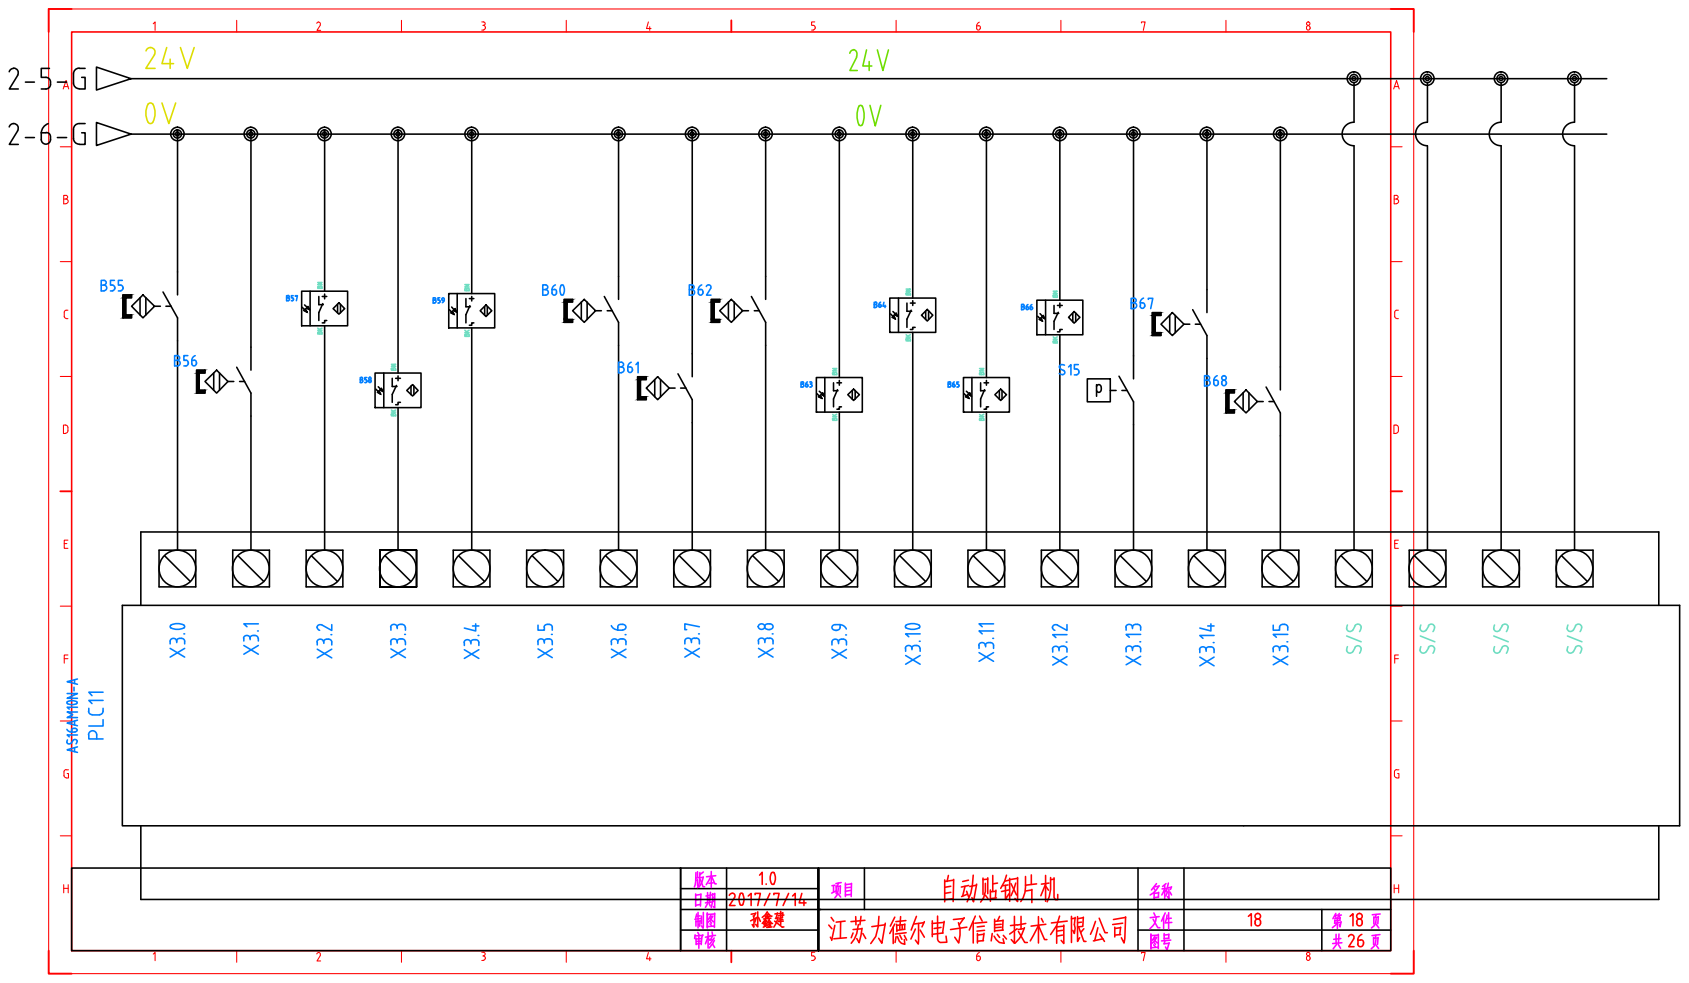
[picture p18: page 18]

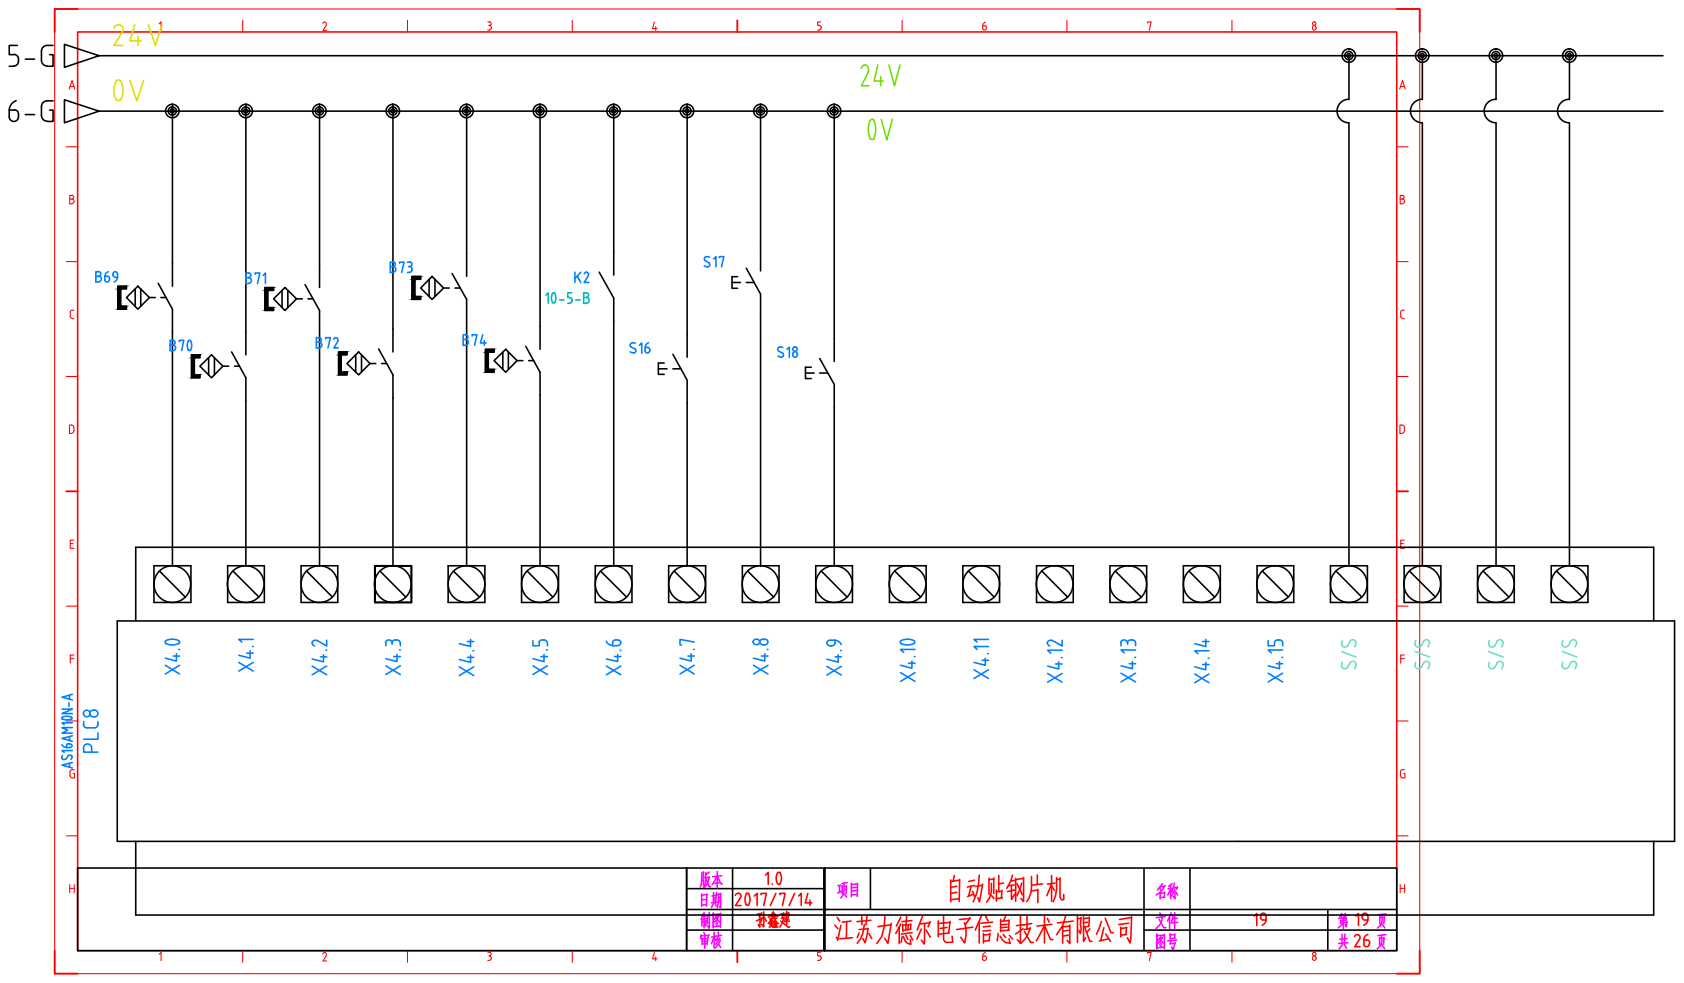
[picture p19: page 19]

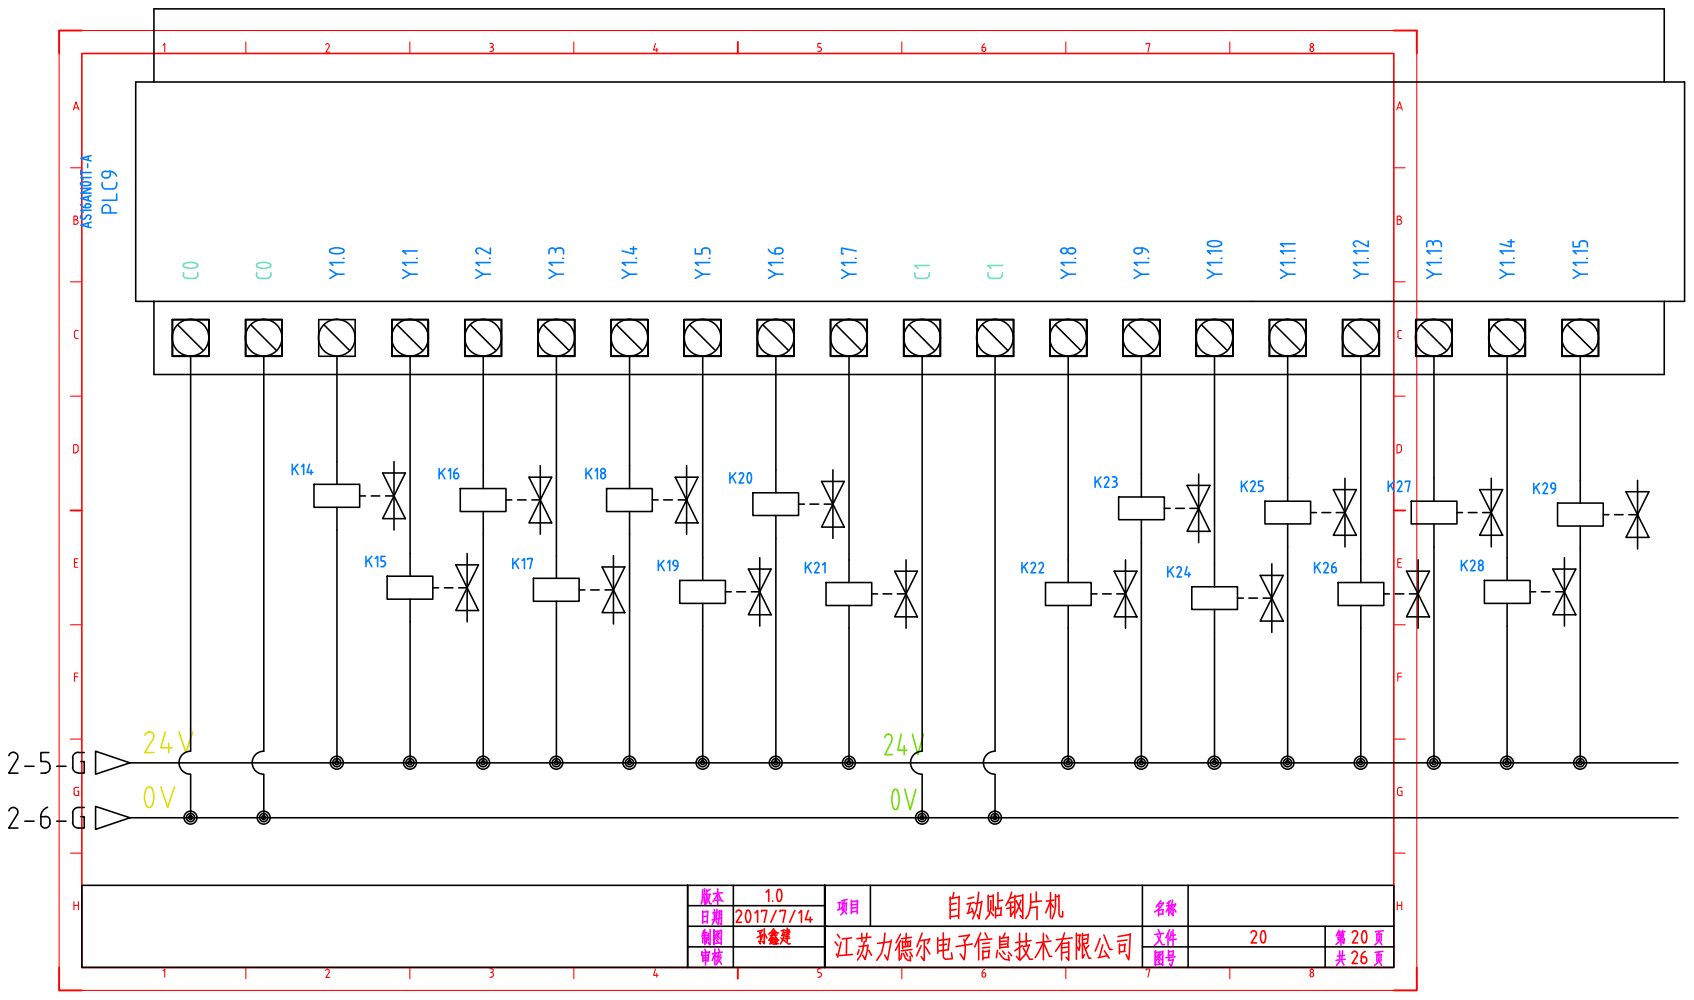
[picture p20: page 20]

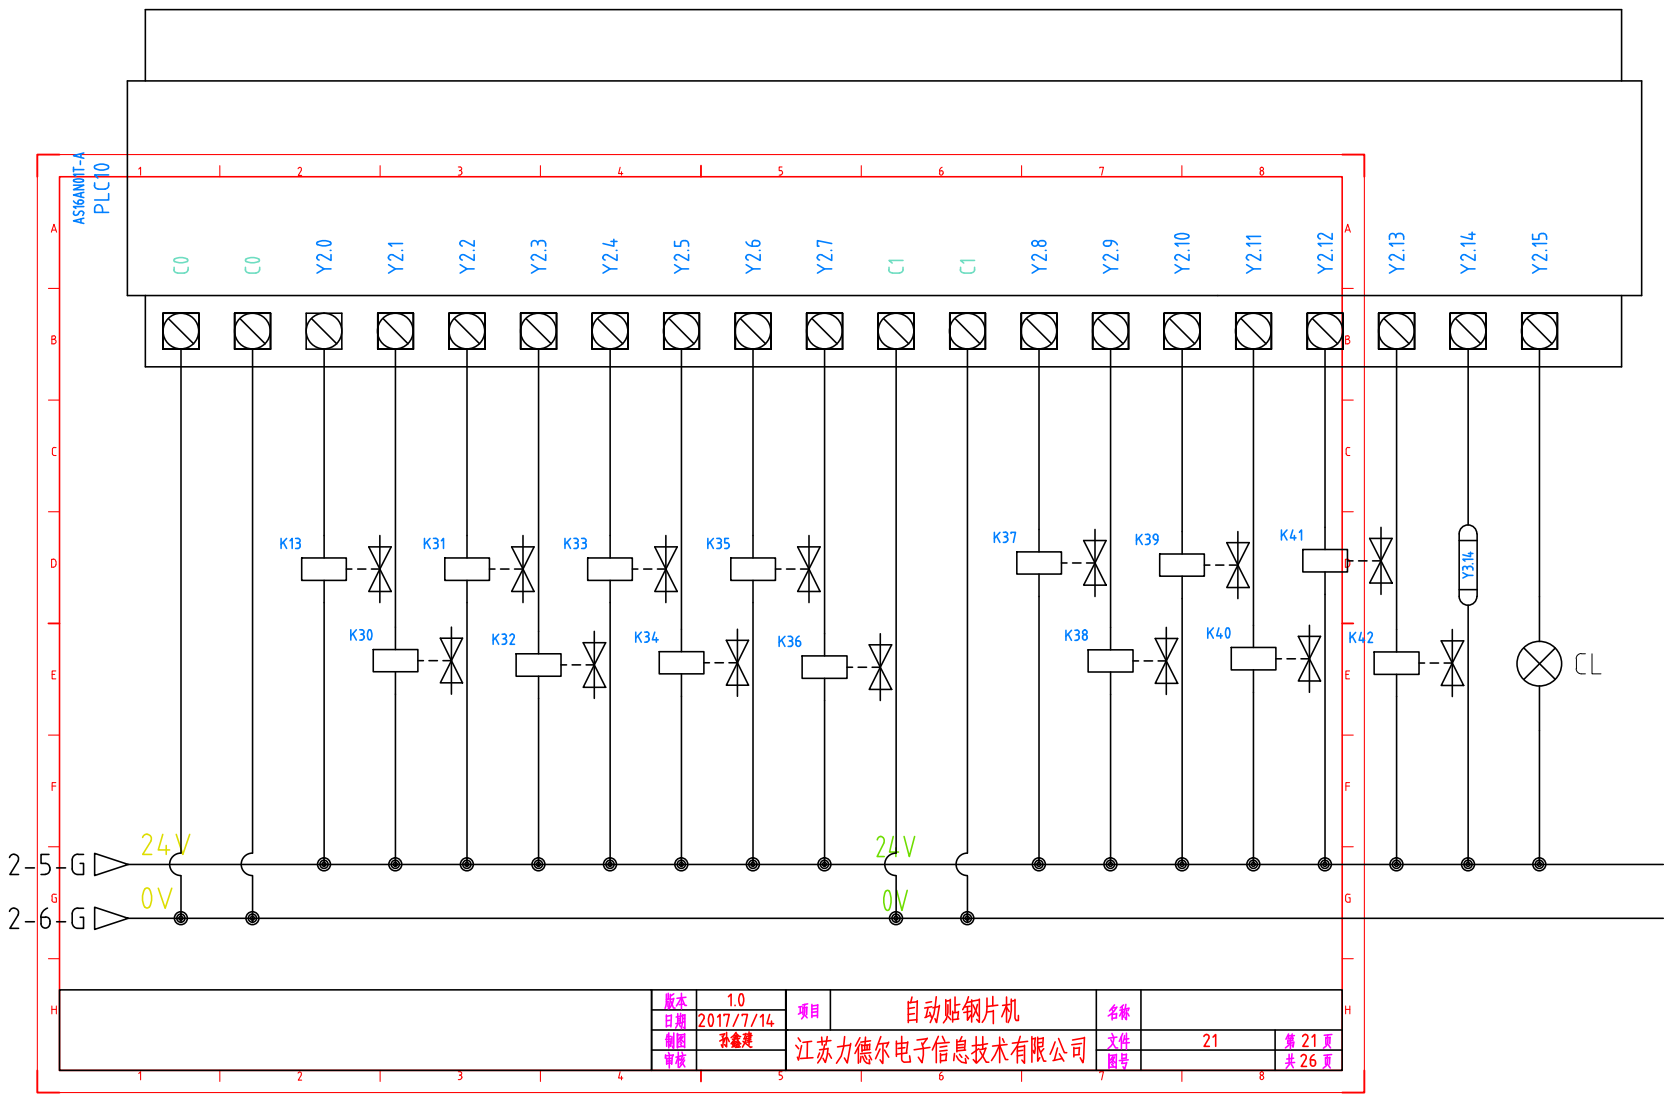
[picture p21: page 21]

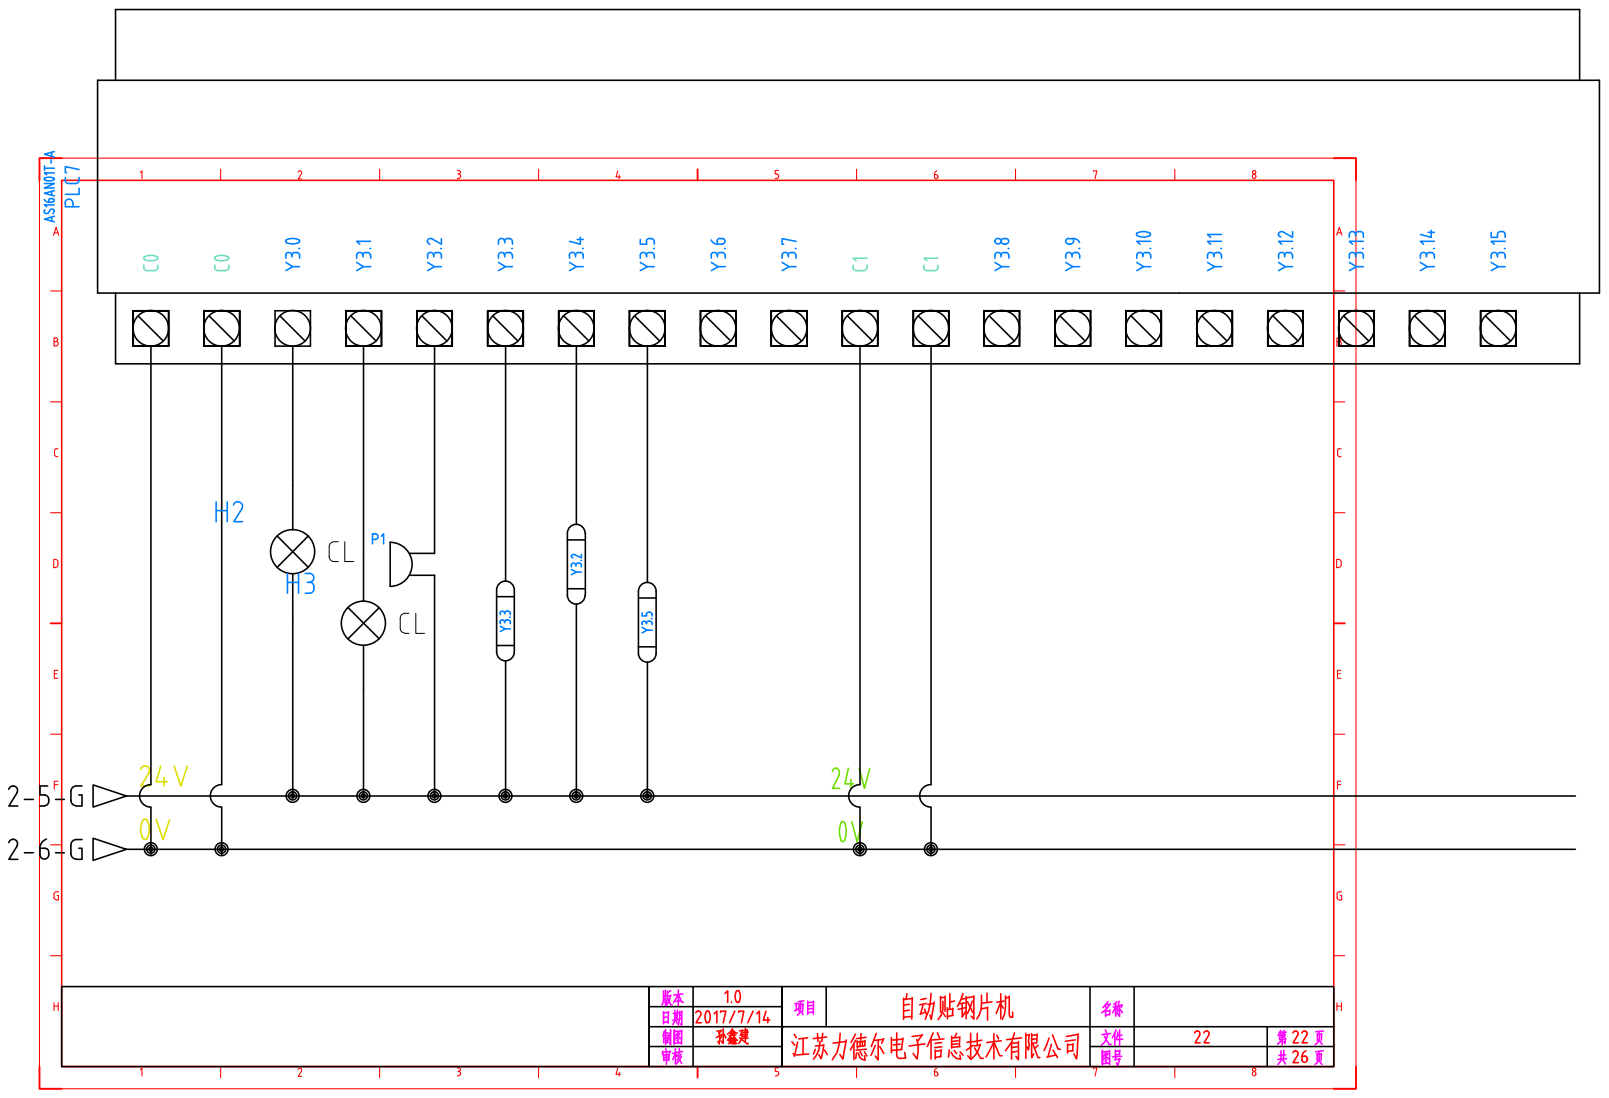
[picture p22: page 22]

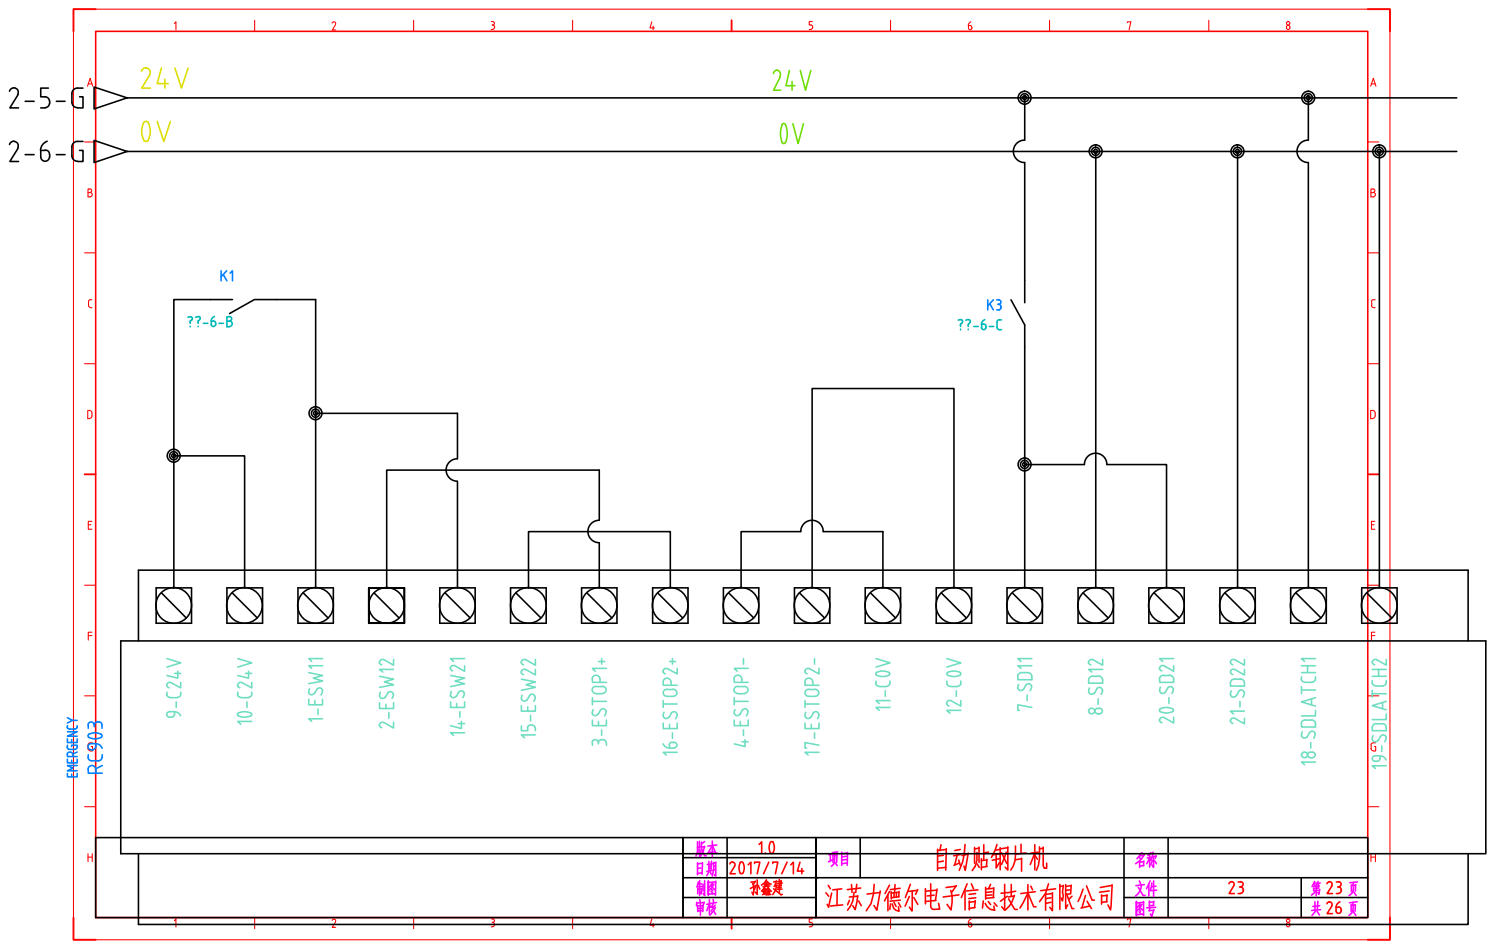
[picture p23: page 23]

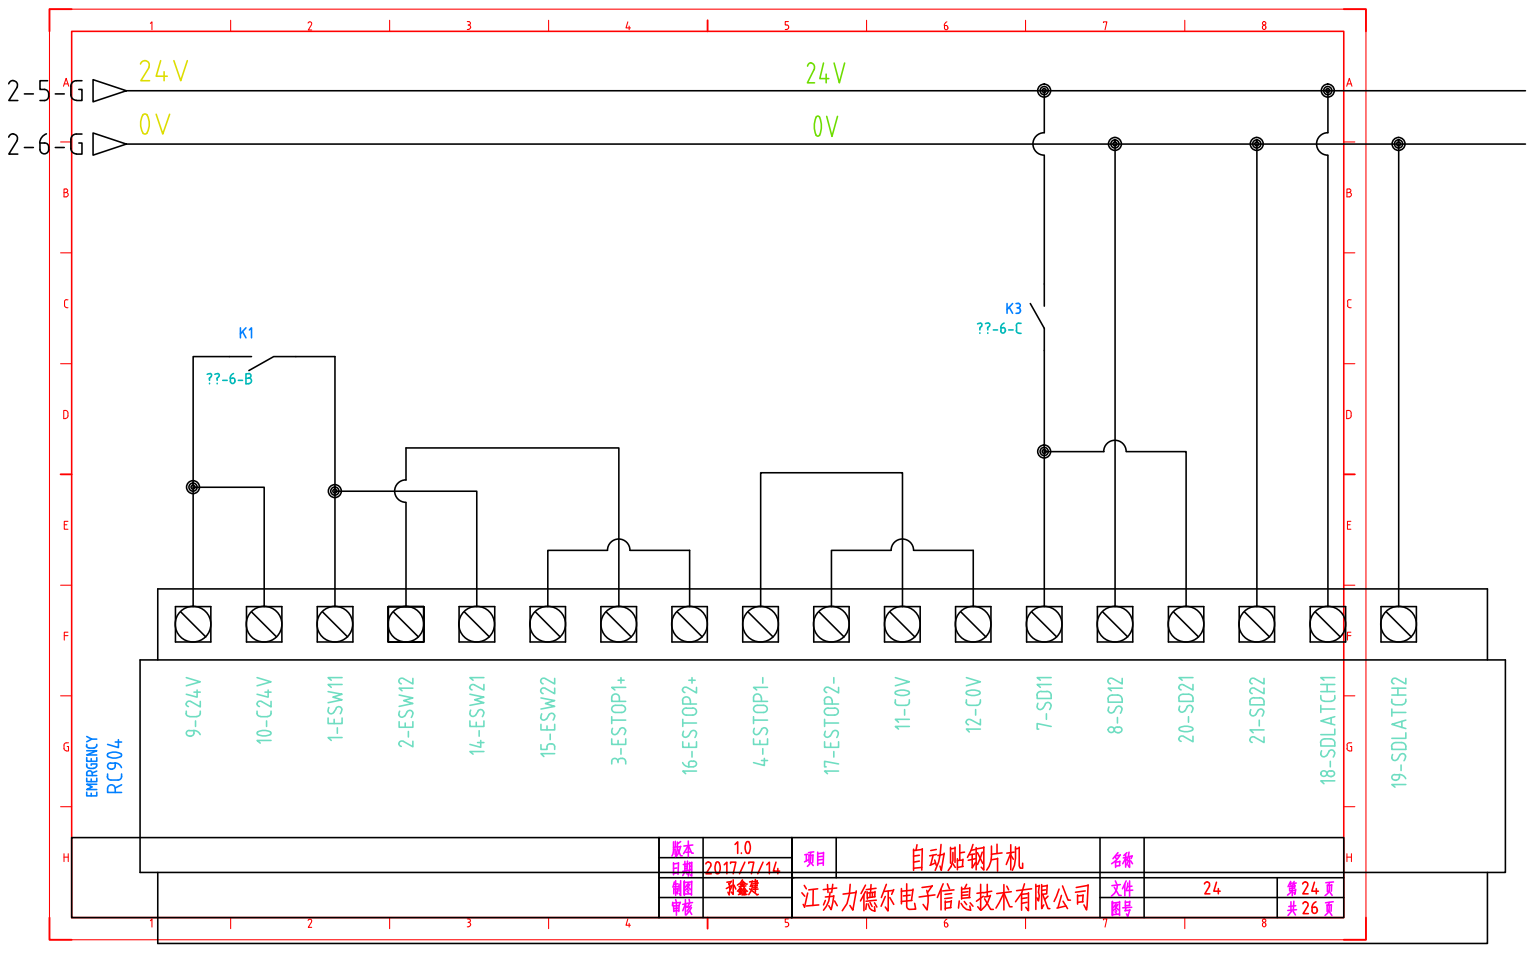
[picture p24: page 24]

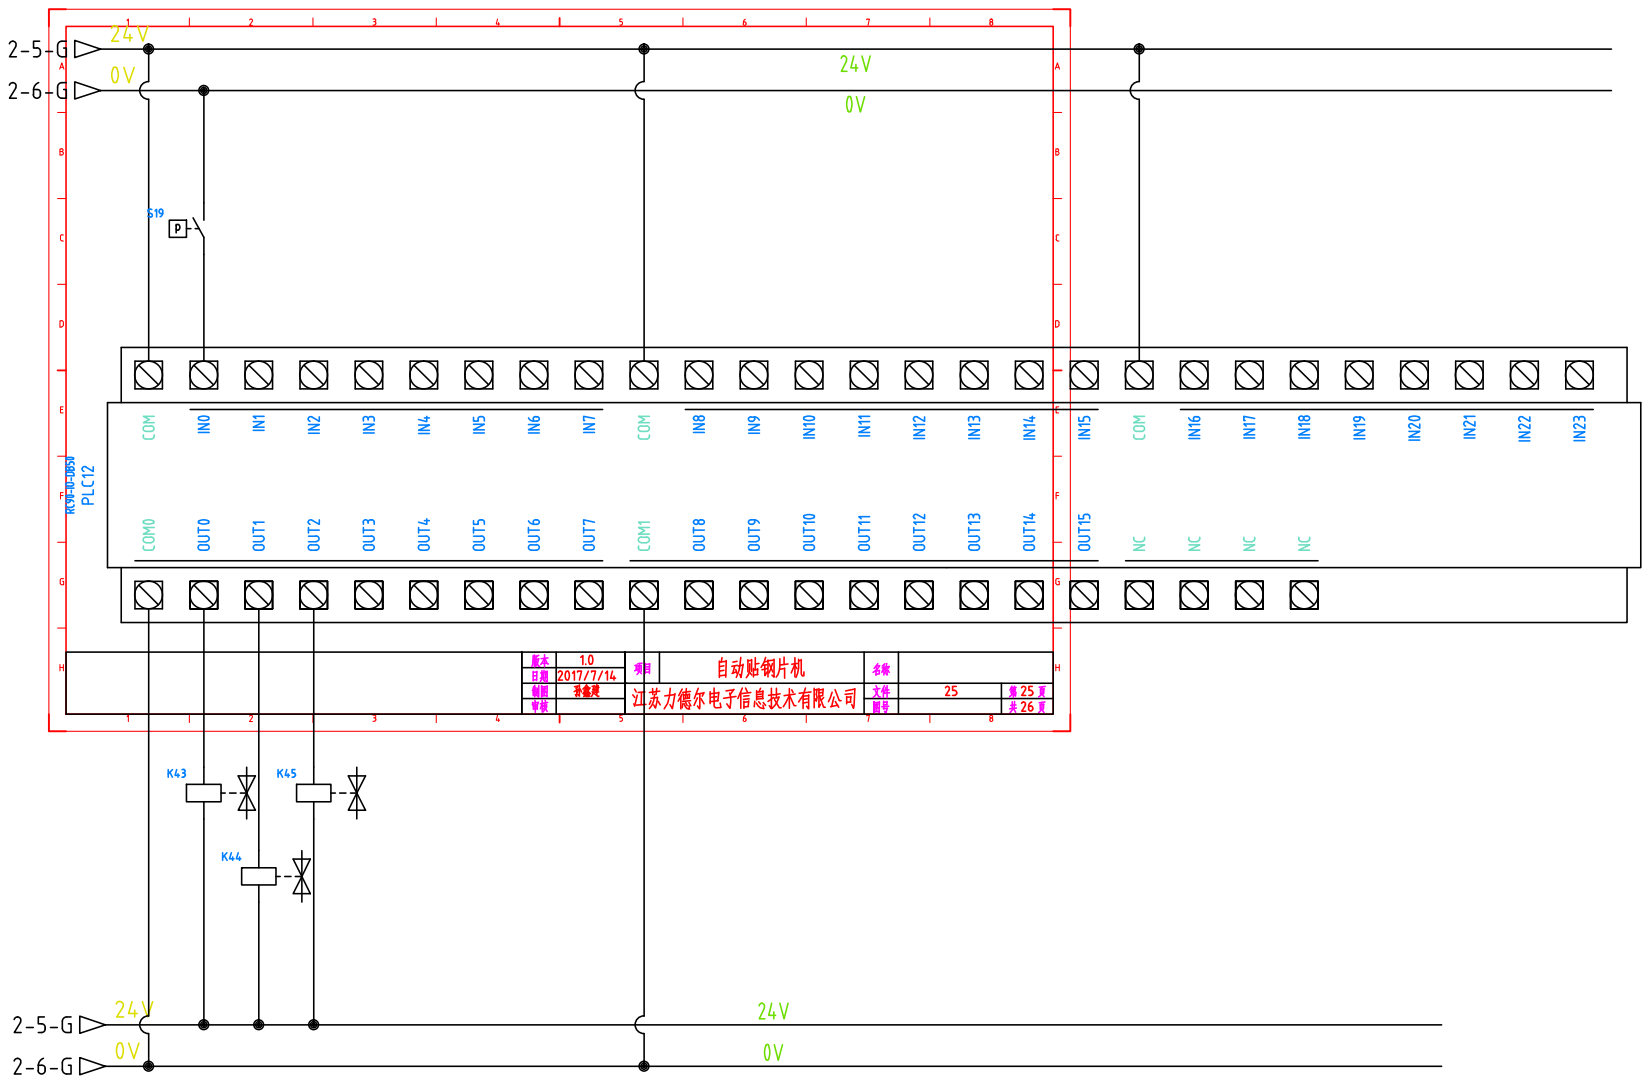
[picture p25: page 25]

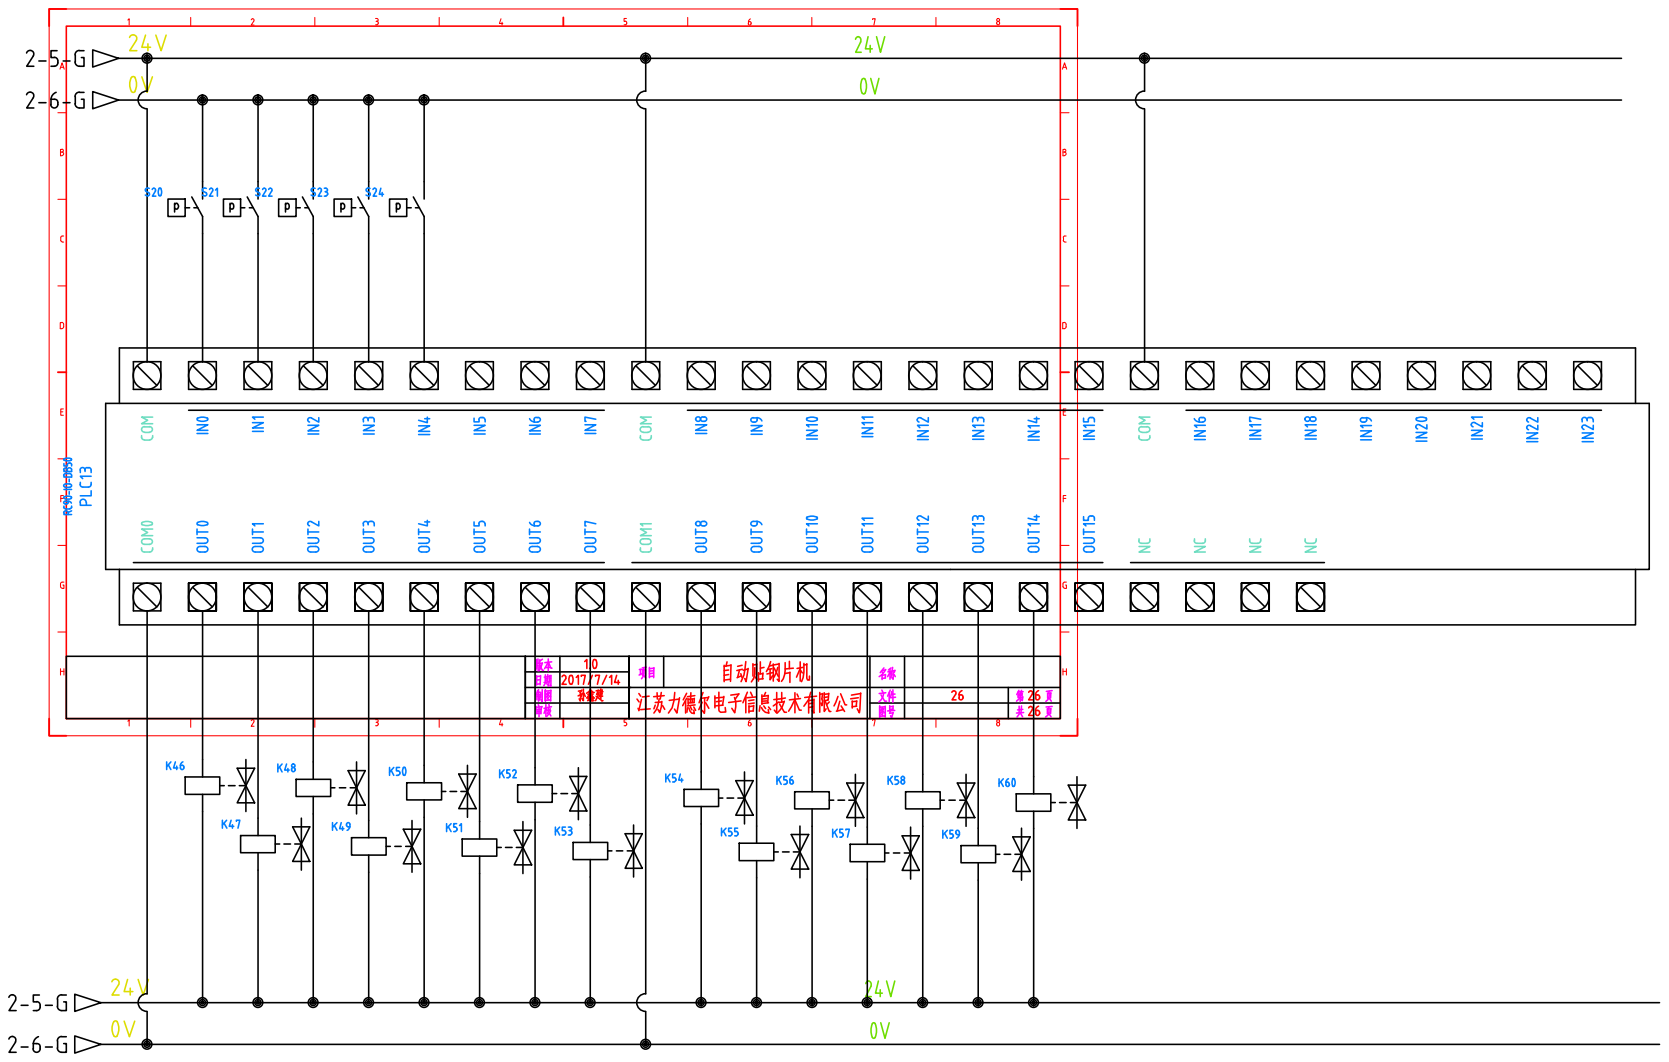
[picture p26: page 26]
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
