LeaderXinjianSun/AutoSteelpasted/PLC/AutoSteelpastedPLC/AutoSteelpastedPLC.ini

[PRJ_DATA]
LANG=CHS
CPU=3000
DEVICE_LABEL=Untitled
SYNCH_ID=
PRI_PATH=
MONITOR_RADIX=0
DEVICE_TYPE=1

[COM_MAN]
DRIVER_ID=0
DRIVER_NAME=
LOCAL_IP=
TARGET_IP=255.255.255.255
TARGET_PORT=502
TARGET_STATION=0
IS_NNU=0
COM_NUM=1
CON_INTERFACE=0
FIRST_STATION=
ETH_CARD_NAME=
ETH_CARD_MAC_ADDR=

[HW_CFG]
RACK_ID1=1

[NW_CFG]

[SLOT00]
MODULE_ID=0x2000001
SYNCH_ID=0
STATION_ADDR1=1
STATION_ADDR2=0
IP1=192.168.1.5
IP2=0
MASK1=255.255.255.0
MASK2=0
DHCP1=0
DHCP2=0
PROTOCOL1=0
PROTOCOL2=0
RETRY_TIMES1=0
RETRY_TIMES2=0
DelayTimeToReply1=0
DelayTimeToReply2=0
TIMEOUT1=200
TIMEOUT2=0
AS_FCOPM_STATION=1
AS_FCOPM_RATE=6

[HW_USED_DEVICE]
Item1=X0#1,[HWCONFIG], L[0,0], AS332T, I/O
Item2=Y0#1,[HWCONFIG], L[0,0], AS332T, I/O
Count=16
Item3=X1#1,[HWCONFIG], L[1,0], AS16AM10N, I/O
Item4=X0#0,[HWCONFIG], L[1,0], AS16AM10N, I/O
Item5=X2#1,[HWCONFIG], L[1,1], AS16AM10N, I/O
Item6=X0#0,[HWCONFIG], L[1,1], AS16AM10N, I/O
Item7=X3#1,[HWCONFIG], L[1,2], AS16AM10N, I/O
Item8=X0#0,[HWCONFIG], L[1,2], AS16AM10N, I/O
Item9=X4#1,[HWCONFIG], L[1,3], AS16AM10N, I/O
Item10=X0#0,[HWCONFIG], L[1,3], AS16AM10N, I/O
Item11=0#0,[HWCONFIG], L[1,4], AS16AN01T, I/O
Item12=Y1#1,[HWCONFIG], L[1,4], AS16AN01T, I/O
Item13=0#0,[HWCONFIG], L[1,5], AS16AN01T, I/O
Item14=Y2#1,[HWCONFIG], L[1,5], AS16AN01T, I/O
Item15=0#0,[HWCONFIG], L[1,6], AS16AN01T, I/O
Item16=Y3#1,[HWCONFIG], L[1,6], AS16AN01T, I/O

[SLOT10]
MODULE_ID=0x2000210
SYNCH_ID=0

[SLOT11]
MODULE_ID=0x2000210
SYNCH_ID=0

[SLOT12]
MODULE_ID=0x2000210
SYNCH_ID=0

[SLOT13]
MODULE_ID=0x2000210
SYNCH_ID=0

[SLOT14]
MODULE_ID=0x2000216
SYNCH_ID=0

[SLOT15]
MODULE_ID=0x2000216
SYNCH_ID=0

[SLOT16]
MODULE_ID=0x2000216
SYNCH_ID=0

[CONNECT_TO]
AH_MC_CONNECT_TYPE=TO AH MC MODULE
AH_CONNECT_RACK=1
AH_CONNECT_SLOT=0
MC_CONNECT_RACK=1
MC_CONNECT_SLOT=0

[MDI_NAME_GROUP]
MDICOUNT=8
MDINAME_0=GlobalVar
MDINAME_1=WorkPCSAction (检测正反工位)_PouType
MDINAME_2=Communication1_1_PouType
MDINAME_3=Communication3_1_PouType
MDINAME_4=Communication3_PouType
MDINAME_5=Communication2_1_PouType
MDINAME_6=Communication2_PouType
MDINAME_7=Communication1_PouType

[GlobalVar]
WindowState=2
Top=-31
Left=-8
Height=481
Width=975

[WorkPCSAction (检测正反工位)_PouType]
WindowState=0
Top=0
Left=0
Height=312
Width=829

[Communication1_1_PouType]
WindowState=0
Top=26
Left=26
Height=377
Width=777

[Communication3_1_PouType]
WindowState=0
Top=130
Left=130
Height=377
Width=777

[Communication3_PouType]
WindowState=0
Top=104
Left=104
Height=377
Width=777

[Communication2_1_PouType]
WindowState=0
Top=78
Left=78
Height=377
Width=777

[Communication2_PouType]
WindowState=0
Top=52
Left=52
Height=377
Width=777

[Communication1_PouType]
WindowState=0
Top=0
Left=0
Height=373
Width=773
