LeaderXinjianSun/AutoSteelpasted/(commit log)

2017-07-20 添加相机物料
    [自动贴钢片机（珠海藤仓）资料.xlsx]
2017-08-02 动作触摸设计完成
    [全局符号.csv]
2017-08-08 传送带能完整运行
    [自动贴钢片机（珠海藤仓）资料.xlsx]
2017-08-09 空跑完成
    [自动贴钢片机（珠海藤仓）资料.xlsx]
2017-08-18 可以整机运行，但仍在解决不稳定文昌塔
    [全局符号.csv, 自动贴钢片机（珠海藤仓）资料.xlsx]
2017-09-05 解决下料标志位被复位问题
    [自动贴钢片机（珠海藤仓）资料.xlsx]
2017-11-21 添加真空报警提示
    [01.dwg, 自动贴钢片机（珠海藤仓）资料.xlsx]
2017-11-21 添加报警处理
    [自动贴钢片机（珠海藤仓）资料.xlsx]
2021-02-10 备份机械手1程序
    [GangpianRobot1.obj, Main.obj]
